Abhishek-Jalkhare/tiny-engineer/docs/3d/parametric-design.md

# Parametric design (different servo sizes)

[`3d_models/cad/TinyEngineer.f3d`](../../3d_models/cad/TinyEngineer.f3d) is the parametric Fusion source for the robot. Printed pockets, mounting tabs, shaft clearance, and M2 screw pilots are driven by Fusion **user parameters**. Change those values and the assembly rebuilds for a different micro servo or a tighter/looser screw fit.

Presets live in [`servos.json`](../../3d_models/fusion/TinyEngineerTools/servos.json). **TinyEngineer Tools** writes them into the `.f3d`, then exports print meshes under `parts/{servo_id}/3mf/` (and matching `stl/`) plus STEP CAD under `parts/{servo_id}/step/`.

```mermaid
flowchart LR
  json["servos.json presets"]
  cfg["Servo Configurator"]
  f3d["TinyEngineer.f3d user params"]
  parts["parts/servo_id meshes"]
  json --> cfg --> f3d --> parts
```

## Which servo

Servo size sets the size of the **whole robot**. Desk, chair, body, and pockets all scale with the preset. Pick the servo first, then print the matching `parts/{servo_id}/3mf/` folder.

Built-in presets in [`servos.json`](../../3d_models/fusion/TinyEngineerTools/servos.json):

| Model | `servo_id` | When to use |
| --- | --- | --- |
| **Tower Pro SG90** (recommended) | `sg90` | Easiest to buy. Bigger desk — electronics are easier to fit and assemble. |
| **Feetech FS0307** | `fs0307` | More compact. Looks better if you want a smaller robot. |
| **EMAX ES9051** | `es9051` | Compact — similar footprint to FS0307, slightly taller body. |
| **PowerHD HD-1370A** | `hd1370a` | Still supported for backward compatibility. Not the pick for a new build. |

A non-standard servo is fine: measure it, add a preset, run the configurator ([Add a new servo](#add-a-new-servo)). Print parts that match that `servo_id`.

Print matching `parts/{servo_id}/3mf/`: [`sg90`](../../3d_models/parts/sg90/3mf/), [`fs0307`](../../3d_models/parts/fs0307/3mf/), [`es9051`](../../3d_models/parts/es9051/3mf/), [`hd1370a`](../../3d_models/parts/hd1370a/3mf/).

## Servo parameters

Each preset in `servos.json` is a map of Fusion user-parameter names to expressions such as `"20 mm"`. The configurator ([`servo.py`](../../3d_models/fusion/TinyEngineerTools/servo.py)) writes those into the open design. It refuses names that are not already user parameters in the `.f3d` — do not invent keys.

Servo body dimensions used as Fusion user parameters

### Body and tabs

| Parameter | Meaning |
| --- | --- |
| `servo_body_width` | Body length between the two mounting tabs (tabs not included). |
| `servo_body_height` | Body height, from the mounting-tab plane to the opposite face. |
| `servo_body_depth` | Body thickness (front to back). |
| `servo_mount_width` | How far each mounting tab sticks out from the body. |
| `servo_mount_thickness` | Tab thickness. |

### Gearbox and shaft stack

| Parameter | Meaning |
| --- | --- |
| `servo_gearbox_height` | Gearbox step sitting on the body. |
| `servo_shaft_housing_height` | Boss around the output shaft, above the gearbox. |
| `servo_gearbox_padding` | How far the gearbox / shaft stack is inset from the body edge (the asymmetric “fat” side of typical micro servos). |

### Shaft

| Parameter | Meaning |
| --- | --- |
| `servo_shaft_position` | Distance from the body end to the shaft axis. |
| `servo_shaft_length` | How far the spline shaft sticks out. |
| `servo_shaft_radius` | Shaft radius (not diameter). |

### Mount holes

`servo_mount_hole_radius` is in `servos.json` but not drawn on the diagram.

| Parameter | Meaning |
| --- | --- |
| `servo_mount_hole_depth_offset` | Hole shift along body depth from the tab centerline. |
| `servo_mount_hole_width_offset` | Hole shift along the tab (toward or away from the body). |
| `servo_mount_hole_radius` | Screw-hole radius in the tabs. |

### Not a dimension

| Parameter | Meaning |
| --- | --- |
| `servo_id` | Short lowercase folder id (`hd1370a`, `fs0307`, `sg90`, `es9051`). The configurator writes it; the exporter uses it. |

## M2 screw holes

Assembly uses **M2 screws** that thread directly into the printed PLA/PETG (no heat-set inserts). Pilot-hole size is a Fusion **user parameter**, not a servo preset:

| Parameter | Meaning |
| --- | --- |
| `screw_thread_diameter` | Modeled diameter of M2 self-tapping pilot holes in the printed parts. |

Related (usually leave alone): `screw_head_diameter`, `screw_head_height` — countersink / head clearance for the same fasteners.

`screw_thread_diameter` is **not** in [`servos.json`](../../3d_models/fusion/TinyEngineerTools/servos.json). Change it in Fusion (**Modify → Change Parameters**), then run **Tiny Engineer Parts Exporter** again.

### Why dial it in

Print tolerances vary by printer, material, and slicer. FDM holes often print smaller than modeled, so the CAD default is slightly oversized relative to an M2 major diameter (~2.0 mm). On some printers the hole still comes out large enough that the screw **slides through** instead of cutting a thread — mounting gets loose.

### Use `ScrewSizingTest` first

1. Print [`ScrewSizingTest.3mf`](../../3d_models/README.md#print-first) from your `parts/{servo_id}/3mf/` folder (quick, small).
2. Each hole is labeled with its diameter (about **2.00–2.40 mm** in **0.05 mm** steps).
3. Drive an M2 screw into each hole. Prefer the **tightest** hole that still lets the screw cut a clean thread (firm bite, not free-spinning, not so tight you strip the plastic).
4. Set `screw_thread_diameter` to that labeled value and re-export before printing the full set.

Print [`ServoSizingTester`](../../3d_models/README.md#print-first) in the same “print first” pass for servo pocket fit.

### Recommended / tested values

| Value | When |
| --- | --- |
| **2.1 mm** | CAD default and shipped `parts/*/3mf/` exports. Tested path on a **Creality Ender 3 V3 SE**, PLA, ~0.16 mm layer height ([printing notes](../hardware-for-software-engineers/06-3d-printing-and-mechanical-build.md)). |
| Smaller (e.g. 2.05–2.15 mm) | Pilot too tight to start a thread without cracking — pick from `ScrewSizingTest`. |
| Larger (e.g. 2.25–2.35 mm) | Screws feel loose / slide through on your printer — pick from `ScrewSizingTest`. |

Always trust **your** `ScrewSizingTest` result over the table if they disagree.

## TinyEngineer Tools add-in

**TinyEngineer Tools** is a Fusion add-in for [`cad/TinyEngineer.f3d`](../../3d_models/cad/TinyEngineer.f3d). It writes servo dimensions from [`TinyEngineerTools/servos.json`](../../3d_models/fusion/TinyEngineerTools/servos.json) into Fusion user parameters, and exports selected `PRINT_LAYOUT` children as `.3mf` / binary `.stl` / `.step` (PRINT_LAYOUT with one child visible, so captured print pose stays). STL/3MF use Save as Mesh; STEP uses File → Export.

Fusion must know about the add-in folder. Folder name, `TinyEngineerTools.py`, and `TinyEngineerTools.manifest` must stay the same.

Official Autodesk steps: [How to install an add-in or script](https://www.autodesk.com/support/technical/article/caas/sfdcarticles/sfdcarticles/How-to-install-an-ADD-IN-and-Script-in-Fusion-360.html).

### Point Fusion at this repo

Fusion remembers the path. Code stays in git. Reload after edits (see below).

1. Open Fusion.
2. Open **Utilities → Add-Ins → Scripts and Add-Ins**. Shortcut: **Shift+S**.
3. Open the **Add-Ins** tab.
4. Click the green **+** next to **Script of add-in from device**.
5. Browse to `3d_models/fusion/TinyEngineerTools/` in this repo and select the folder.
6. Select **TinyEngineerTools** in the list and click **Run**.
7. Optional: enable **Run on Startup** so Fusion starts it every launch.

### Use the commands

Open [`cad/TinyEngineer.f3d`](../../3d_models/cad/TinyEngineer.f3d) and stay in the **Design** workspace. Both commands live under **Utilities → Add-ins**.

#### TinyEngineer Servo Configurator

Select a servo model and apply dimensions, including `servo_id` (short lowercase id such as `sg90`).

The command reads [`servos.json`](../../3d_models/fusion/TinyEngineerTools/servos.json), previews the values, and writes them into the design’s user parameters. Use this to preview a preset in the open design; Parts Exporter can also apply selected servos during export.

#### Tiny Engineer Parts Exporter

A command dialog asks what to export (all checkboxes **on** by default):

* **Servos** — each preset in [`servos.json`](../../3d_models/fusion/TinyEngineerTools/servos.json)
* **Parts** — each direct `PRINT_LAYOUT` child in a scrollable table, with **Select all** / **Deselect all**
* **Formats** — `3MF`, `STL`, `STEP`

Then choose an export folder.

For each selected servo the add-in applies that preset’s parameters, then exports each selected part separately. For each part it temporarily hides the others, keeps that child visible in its saved print orientation, and writes the checked formats under that servo’s folder:

* `{servo_id}/3mf/{name}.3mf` (if 3MF selected)
* `{servo_id}/stl/{name}.stl` binary STL (if STL selected)
* `{servo_id}/step/{name}.step` STEP CAD via File → Export (if STEP selected)
* `{servo_id}/README.md` with that servo’s parameters from `servos.json`

After the run, visibility and the design’s previous servo parameters are restored. A progress dialog stays up so Fusion can paint; Cancel stops after the current part.

## Add a new servo

1. Measure a real unit (prefer calipers over datasheet marketing sizes).
2. Copy an existing object in [`servos.json`](../../3d_models/fusion/TinyEngineerTools/servos.json); keep the same keys; set a unique `servo_id`.
3. Reload the add-in, run Servo Configurator, confirm Fusion parameters update.
4. Print [`ServoSizingTester`](../../3d_models/README.md#print-first) and [`ScrewSizingTest`](../../3d_models/README.md#print-first) first (servo pocket + M2 pilot), then export.

The configurator refuses unknown Fusion parameter names. Do not invent keys that are not already user parameters in the `.f3d`.
