Abhishek-Jalkhare/tiny-engineer/3d_models/laptop_screens/laptop-screens-es9051.pdf

# Tiny Engineer - laptop screen inserts: Printed background

Servo preset: EMAX ES9051 (es9051) | Print one page that suits your printer.

Background and text in colour; a black-only printer prints them as greys. Most ink.
Insert 37.2 x 28.4 mm (cut on the grey line). Visible window 36.8 x 19.9 mm, 0.2 mm from the left and 1.7 mm from the top edge.
Slide the paper insert, then a same-size piece of clear PET, into the lid pocket in front of LaptopScreen.
10 mm | 0 | 10 | 20 | 30 | 40 | 50 Square must measure 10 x 10 mm and the ruler 50 mm. If not, reprint at 100% / Actual size (scaling off).

~/tiny-engineer$ pio run
Processing esp32-c3-devkitm-1 (espressif32) -------------------------------------------Compiling .pio/build/src/anim/poses.cpp.o Compiling .pio/build/src/http/routes.cpp.o Compiling .pio/build/src/servos/park.cpp.o Linking .pio/build/firmware.elf
Checking size .pio/build/firmware.elf
RAM: | [== | ] 17.4% (57012 bytes)
Flash: [===== | ] 52.1% (1023890 bytes)
Building .pio/build/firmware.bin
========== [SUCCESS] Took 12.84 seconds ========== ~/tiny-engineer$ _

# es9051 - Build output

1 // wave hello, then get back to work 2 void greet(Robot &bot) {
3 | for (int i = 0; i < 3; i++) {
4 | bot.arm(Side::Right, 0.8f);
5 | delay(180);
6 | bot.arm(Side::Right, -0.2f);
7 | delay(180);
8 | }
9 | bot.say("Hello, world!");
10 | bot.pose("typing");
11 }
12

# es9051 - Source code

> fix the failing servo test

* Reading test/servos/test_park.cpp
* The test expects the elbow to park at 0.0, but the default is now -0.1.
* Updating the expected value...
- TEST_ASSERT_EQUAL_FLOAT(0.0f, pose); + TEST_ASSERT_EQUAL_FLOAT(-0.1f, pose); * Ran pio test -e native: 42 passed

> _

# es9051 - AI agent chat

Guru Meditation Error: Core 0 panic'ed
(Load access fault). Exception was unhandled.

Core 0 register dump:
MEPC | : 0x42008a3e RA | : 0x42008a1c
SP | : 0x3fc9b2f0 GP | : 0x3fc8e400
MTVAL | : 0x00000000 <- null pointer

Backtrace:
0x42008a3e in Coffee::refill() at mug.cpp:42 0x42004f10 in Engineer::morning() at day.cpp:7 0x42003c88 in loop() at main.cpp:118

Rebooting...

# es9051 - Crash / stack trace

**** TINY ENGINEER BASIC V2 ****
64K RAM SYSTEM 38911 BASIC BYTES FREE

READY.
10 PRINT "HELLO, HUMAN"
20 GOTO 10
RUN
HELLO, HUMAN
HELLO, HUMAN
HELLO, HUMAN
HELLO, HUMAN
BREAK IN 10
READY.
_

# es9051 - Retro computer

HOW DO YOU DO. PLEASE STATE YOUR PROBLEM. > My robot keeps waving at me.
WHY DO YOU SAY YOUR ROBOT KEEPS WAVING AT YOU?
> Maybe it wants a coffee.
YOU DON'T SEEM QUITE CERTAIN.
> I am never certain before coffee. HOW LONG HAVE YOU BEEN NEVER CERTAIN BEFORE COFFEE?
> Since I started writing firmware. TELL ME MORE ABOUT WRITING FIRMWARE. > _

# es9051 - ELIZA-style chat

| o o |
'--+--'
/| |\

### |___|

### TINY ENGINEER

booting desk robot...
[##########--------]

# es9051 - Tiny Engineer splash

## draw or glue your screen inside the dashed line (visible area)

# es9051 - Blank template

$ explain --to duck src/servos/park.cpp

__
<(o )___ | So the elbow parks at 0.0
( ._> / | because the default is...
`---'
| ...-0.1. Oh.
| Never mind. Thanks, duck.

duck: *squeak*

# es9051 - Rubber duck debugging

.--. | [ | 0.000000] Linux version 6.12-te
|o_o | | [ | 0.412718] esp32: hello from below
|:_/ | | [ OK ] Mounted /desk
// | \ \ | [ OK ] Started coffee.service
(| | | ) | [ OK ] Started tiny-engineer.service
/'\_ | _/`\ | [ OK ] Reached target Productivity
\___)=(___/

tiny-engineer login: _

Tux by Larry Ewing, made with The GIMP

# es9051 - Linux boot (Tux)

SCORE 00420 | HI 09001
#o###o# | #o###o# | #o###o# | #o###o#

/ ' ' \ | / ' ' \ | / ' ' \ | / ' ' \
| | | _/^\_
LIVES ^ ^ ^ | CREDIT 01

# es9051 - Pixel aliens

################ | > mining...

## | #### | ## | > found: 3 x coffee bean

## | #### | ## | > found: 1 x loose M2 screw

#### | | #### | A quiet green neighbour

#### #### #### | is standing behind

#### #### #### | the robot.

# es9051 - Blocky neighbour

| .-------. | | TE-9000 DESK UNIT
| .' .---. '. | | all systems nominal
/ | ( (@) ) | \
\ | '---' | / | > open the pod bay doors
'. | .'
| '-------' | | I can't do that.
| | | I can open a pull
| | | request, though.

# es9051 - TE-9000 console

~/tiny-engineer$ pio run
Processing esp32-c3-devkitm-1 (espressif32) -------------------------------------------Compiling .pio/build/src/anim/poses.cpp.o Compiling .pio/build/src/http/routes.cpp.o Compiling .pio/build/src/servos/park.cpp.o Linking .pio/build/firmware.elf
Checking size .pio/build/firmware.elf
RAM: | [== | ] 17.4% (57012 bytes)
Flash: [===== | ] 52.1% (1023890 bytes)
Building .pio/build/firmware.bin
========== [SUCCESS] Took 12.84 seconds ========== ~/tiny-engineer$ _

# es9051 - Build output

1 // wave hello, then get back to work 2 void greet(Robot &bot) {
3 | for (int i = 0; i < 3; i++) {
4 | bot.arm(Side::Right, 0.8f);
5 | delay(180);
6 | bot.arm(Side::Right, -0.2f);
7 | delay(180);
8 | }
9 | bot.say("Hello, world!");
10 | bot.pose("typing");
11 }
12

# es9051 - Source code

> fix the failing servo test

* Reading test/servos/test_park.cpp
* The test expects the elbow to park at 0.0, but the default is now -0.1.
* Updating the expected value...
- TEST_ASSERT_EQUAL_FLOAT(0.0f, pose); + TEST_ASSERT_EQUAL_FLOAT(-0.1f, pose); * Ran pio test -e native: 42 passed

> _

# es9051 - AI agent chat

Guru Meditation Error: Core 0 panic'ed
(Load access fault). Exception was unhandled.

Core 0 register dump:
MEPC | : 0x42008a3e RA | : 0x42008a1c
SP | : 0x3fc9b2f0 GP | : 0x3fc8e400
MTVAL | : 0x00000000 <- null pointer

Backtrace:
0x42008a3e in Coffee::refill() at mug.cpp:42 0x42004f10 in Engineer::morning() at day.cpp:7 0x42003c88 in loop() at main.cpp:118

Rebooting...

# es9051 - Crash / stack trace

**** TINY ENGINEER BASIC V2 ****
64K RAM SYSTEM 38911 BASIC BYTES FREE

READY.
10 PRINT "HELLO, HUMAN"
20 GOTO 10
RUN
HELLO, HUMAN
HELLO, HUMAN
HELLO, HUMAN
HELLO, HUMAN
BREAK IN 10
READY.
_

# es9051 - Retro computer

HOW DO YOU DO. PLEASE STATE YOUR PROBLEM. > My robot keeps waving at me.
WHY DO YOU SAY YOUR ROBOT KEEPS WAVING AT YOU?
> Maybe it wants a coffee.
YOU DON'T SEEM QUITE CERTAIN.
> I am never certain before coffee. HOW LONG HAVE YOU BEEN NEVER CERTAIN BEFORE COFFEE?
> Since I started writing firmware. TELL ME MORE ABOUT WRITING FIRMWARE. > _

# es9051 - ELIZA-style chat

| o o |
'--+--'
/| |\

### |___|

### TINY ENGINEER

booting desk robot...
[##########--------]

# es9051 - Tiny Engineer splash

## draw or glue your screen inside the dashed line (visible area)

# es9051 - Blank template

$ explain --to duck src/servos/park.cpp

__
<(o )___ | So the elbow parks at 0.0
( ._> / | because the default is...
`---'
| ...-0.1. Oh.
| Never mind. Thanks, duck.

duck: *squeak*

# es9051 - Rubber duck debugging

.--. | [ | 0.000000] Linux version 6.12-te
|o_o | | [ | 0.412718] esp32: hello from below
|:_/ | | [ OK ] Mounted /desk
// | \ \ | [ OK ] Started coffee.service
(| | | ) | [ OK ] Started tiny-engineer.service
/'\_ | _/`\ | [ OK ] Reached target Productivity
\___)=(___/

tiny-engineer login: _

Tux by Larry Ewing, made with The GIMP

# es9051 - Linux boot (Tux)

SCORE 00420 | HI 09001
#o###o# | #o###o# | #o###o# | #o###o#

/ ' ' \ | / ' ' \ | / ' ' \ | / ' ' \
| | | _/^\_
LIVES ^ ^ ^ | CREDIT 01

# es9051 - Pixel aliens

# Tiny Engineer - laptop screen inserts: No background, colour text

Colour printer. Only the text prints, darkened to read on pale paper; the paper shows through.
Insert 37.2 x 28.4 mm (cut on the grey line). Visible window 36.8 x 19.9 mm, 0.2 mm from the left and 1.7 mm from the top edge. Slide the paper insert, then a same-size piece of clear PET, into the lid pocket in front of LaptopScreen.
10 mm | 0 | 10 | 20 | 30 | 40 | 50 Square must measure 10 x 10 mm and the ruler 50 mm. If not, reprint at 100% / Actual size (scaling off).

~/tiny-engineer$ pio run
Processing esp32-c3-devkitm-1 (espressif32) -------------------------------------------Compiling .pio/build/src/anim/poses.cpp.o Compiling .pio/build/src/http/routes.cpp.o Compiling .pio/build/src/servos/park.cpp.o Linking .pio/build/firmware.elf
Checking size .pio/build/firmware.elf
RAM: | [== | ] 17.4% (57012 bytes)
Flash: [===== | ] 52.1% (1023890 bytes)
Building .pio/build/firmware.bin
========== [SUCCESS] Took 12.84 seconds ========== ~/tiny-engineer$ _

# es9051 - Build output

1 // wave hello, then get back to work 2 void greet(Robot &bot) {
3 | for (int i = 0; i < 3; i++) {
4 | bot.arm(Side::Right, 0.8f);
5 | delay(180);
6 | bot.arm(Side::Right, -0.2f);
7 | delay(180);
8 | }
9 | bot.say("Hello, world!");
10 | bot.pose("typing");
11 }
12

# es9051 - Source code

> fix the failing servo test

* Reading test/servos/test_park.cpp
* The test expects the elbow to park at 0.0, but the default is now -0.1.
* Updating the expected value...
- TEST_ASSERT_EQUAL_FLOAT(0.0f, pose); + TEST_ASSERT_EQUAL_FLOAT(-0.1f, pose); * Ran pio test -e native: 42 passed

> _

# es9051 - AI agent chat

Guru Meditation Error: Core 0 panic'ed
(Load access fault). Exception was unhandled.

Core 0 register dump:
MEPC | : 0x42008a3e RA | : 0x42008a1c
SP | : 0x3fc9b2f0 GP | : 0x3fc8e400
MTVAL | : 0x00000000 <- null pointer

Backtrace:
0x42008a3e in Coffee::refill() at mug.cpp:42 0x42004f10 in Engineer::morning() at day.cpp:7 0x42003c88 in loop() at main.cpp:118

Rebooting...

# es9051 - Crash / stack trace

**** TINY ENGINEER BASIC V2 ****
64K RAM SYSTEM 38911 BASIC BYTES FREE

READY.
10 PRINT "HELLO, HUMAN"
20 GOTO 10
RUN
HELLO, HUMAN
HELLO, HUMAN
HELLO, HUMAN
HELLO, HUMAN
BREAK IN 10
READY.
_

# es9051 - Retro computer

HOW DO YOU DO. PLEASE STATE YOUR PROBLEM. > My robot keeps waving at me.
WHY DO YOU SAY YOUR ROBOT KEEPS WAVING AT YOU?
> Maybe it wants a coffee.
YOU DON'T SEEM QUITE CERTAIN.
> I am never certain before coffee. HOW LONG HAVE YOU BEEN NEVER CERTAIN BEFORE COFFEE?
> Since I started writing firmware. TELL ME MORE ABOUT WRITING FIRMWARE. > _

# es9051 - ELIZA-style chat

| o o |
'--+--'
/| |\

### |___|

### TINY ENGINEER

booting desk robot...
[##########--------]

# es9051 - Tiny Engineer splash

## draw or glue your screen inside the dashed line (visible area)

# es9051 - Blank template

$ explain --to duck src/servos/park.cpp

__
<(o )___ | So the elbow parks at 0.0
( ._> / | because the default is...
`---'
| ...-0.1. Oh.
| Never mind. Thanks, duck.

duck: *squeak*

# es9051 - Rubber duck debugging

.--. | [ | 0.000000] Linux version 6.12-te
|o_o | | [ | 0.412718] esp32: hello from below
|:_/ | | [ OK ] Mounted /desk
// | \ \ | [ OK ] Started coffee.service
(| | | ) | [ OK ] Started tiny-engineer.service
/'\_ | _/`\ | [ OK ] Reached target Productivity
\___)=(___/

tiny-engineer login: _

Tux by Larry Ewing, made with The GIMP

# es9051 - Linux boot (Tux)

SCORE 00420 | HI 09001
#o###o# | #o###o# | #o###o# | #o###o#

/ ' ' \ | / ' ' \ | / ' ' \ | / ' ' \
| | | _/^\_
LIVES ^ ^ ^ | CREDIT 01

# es9051 - Pixel aliens

################ | > mining...

## | #### | ## | > found: 3 x coffee bean

## | #### | ## | > found: 1 x loose M2 screw

#### | | #### | A quiet green neighbour

#### #### #### | is standing behind

#### #### #### | the robot.

# es9051 - Blocky neighbour

| .-------. | | TE-9000 DESK UNIT
| .' .---. '. | | all systems nominal
/ | ( (@) ) | \
\ | '---' | / | > open the pod bay doors
'. | .'
| '-------' | | I can't do that.
| | | I can open a pull
| | | request, though.

# es9051 - TE-9000 console

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

# es9051 - Build output

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

# es9051 - Source code

> fix the failing servo test

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

> _

# es9051 - AI agent chat

Guru Meditation Error: Core 0 panic'ed
(Load access fault). Exception was unhandled.

Core 0 register dump:
MEPC | : 0x42008a3e RA | : 0x42008a1c
SP | : 0x3fc9b2f0 GP | : 0x3fc8e400
MTVAL | : 0x00000000 <- null pointer

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

Rebooting...

# es9051 - Crash / stack trace

**** TINY ENGINEER BASIC V2 ****
64K RAM SYSTEM 38911 BASIC BYTES FREE

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

# es9051 - Retro computer

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

# es9051 - ELIZA-style chat

| o o |
'--+--'
/| |\

### |___|

### TINY ENGINEER

booting desk robot...
[##########--------]

# es9051 - Tiny Engineer splash

## draw or glue your screen inside the dashed line (visible area)

# es9051 - Blank template

$ explain --to duck src/servos/park.cpp

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

duck: *squeak*

# es9051 - Rubber duck debugging

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

tiny-engineer login: _

Tux by Larry Ewing, made with The GIMP

# es9051 - Linux boot (Tux)

SCORE 00420 | HI 09001
#o###o# | #o###o# | #o###o# | #o###o#

/ ' ' \ | / ' ' \ | / ' ' \ | / ' ' \
| | | _/^\_
LIVES ^ ^ ^ | CREDIT 01

# es9051 - Pixel aliens

# Tiny Engineer - laptop screen inserts: No background, black text

Any printer. Only the text prints, in black and grey; the paper shows through. Least ink.
Insert 37.2 x 28.4 mm (cut on the grey line). Visible window 36.8 x 19.9 mm, 0.2 mm from the left and 1.7 mm from the top edge. Slide the paper insert, then a same-size piece of clear PET, into the lid pocket in front of LaptopScreen.
10 mm | 0 | 10 | 20 | 30 | 40 | 50 Square must measure 10 x 10 mm and the ruler 50 mm. If not, reprint at 100% / Actual size (scaling off).

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

# es9051 - Build output

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

# es9051 - Source code

> fix the failing servo test

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

> _

# es9051 - AI agent chat

Guru Meditation Error: Core 0 panic'ed
(Load access fault). Exception was unhandled.

Core 0 register dump:
MEPC | : 0x42008a3e RA | : 0x42008a1c
SP | : 0x3fc9b2f0 GP | : 0x3fc8e400
MTVAL | : 0x00000000 <- null pointer

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

Rebooting...

# es9051 - Crash / stack trace

**** TINY ENGINEER BASIC V2 ****
64K RAM SYSTEM 38911 BASIC BYTES FREE

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

# es9051 - Retro computer

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

# es9051 - ELIZA-style chat

| o o |
'--+--'
/| |\

### |___|

### TINY ENGINEER

booting desk robot...
[##########--------]

# es9051 - Tiny Engineer splash

## draw or glue your screen inside the dashed line (visible area)

# es9051 - Blank template

$ explain --to duck src/servos/park.cpp

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

duck: *squeak*

# es9051 - Rubber duck debugging

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

tiny-engineer login: _

Tux by Larry Ewing, made with The GIMP

# es9051 - Linux boot (Tux)

SCORE 00420 | HI 09001
#o###o# | #o###o# | #o###o# | #o###o#

/ ' ' \ | / ' ' \ | / ' ' \ | / ' ' \
| | | _/^\_
LIVES ^ ^ ^ | CREDIT 01

# es9051 - Pixel aliens

################ | > mining...

## | #### | ## | > found: 3 x coffee bean

## | #### | ## | > found: 1 x loose M2 screw

#### | | #### | A quiet green neighbour

#### #### #### | is standing behind

#### #### #### | the robot.

# es9051 - Blocky neighbour

| .-------. | | TE-9000 DESK UNIT
| .' .---. '. | | all systems nominal
/ | ( (@) ) | \
\ | '---' | / | > open the pod bay doors
'. | .'
| '-------' | | I can't do that.
| | | I can open a pull
| | | request, though.

# es9051 - TE-9000 console

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

# es9051 - Build output

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

# es9051 - Source code

> fix the failing servo test

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

> _

# es9051 - AI agent chat

Guru Meditation Error: Core 0 panic'ed
(Load access fault). Exception was unhandled.

Core 0 register dump:
MEPC | : 0x42008a3e RA | : 0x42008a1c
SP | : 0x3fc9b2f0 GP | : 0x3fc8e400
MTVAL | : 0x00000000 <- null pointer

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

Rebooting...

# es9051 - Crash / stack trace

**** TINY ENGINEER BASIC V2 ****
64K RAM SYSTEM 38911 BASIC BYTES FREE

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

# es9051 - Retro computer

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

# es9051 - ELIZA-style chat

| o o |
'--+--'
/| |\

### |___|

### TINY ENGINEER

booting desk robot...
[##########--------]

# es9051 - Tiny Engineer splash

## draw or glue your screen inside the dashed line (visible area)

# es9051 - Blank template

$ explain --to duck src/servos/park.cpp

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

duck: *squeak*

# es9051 - Rubber duck debugging

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

tiny-engineer login: _

Tux by Larry Ewing, made with The GIMP

# es9051 - Linux boot (Tux)

SCORE 00420 | HI 09001
#o###o# | #o###o# | #o###o# | #o###o#

/ ' ' \ | / ' ' \ | / ' ' \ | / ' ' \
| | | _/^\_
LIVES ^ ^ ^ | CREDIT 01

# es9051 - Pixel aliens
