Abhishek-Jalkhare/tiny-engineer/web/media/video_preview.jpg

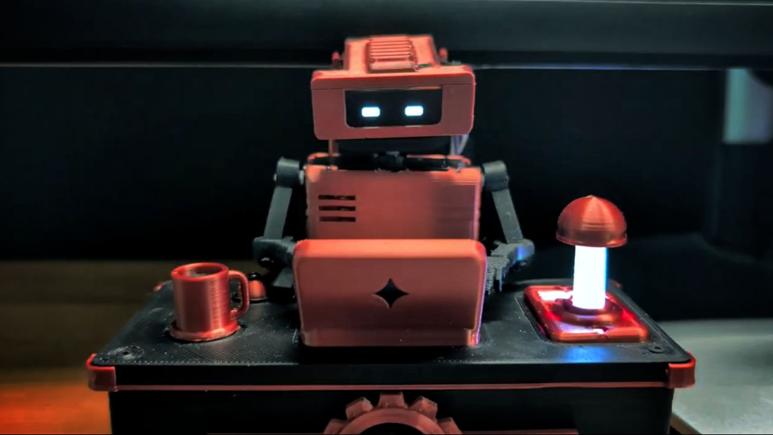
web/media/video_preview.jpg
