Abhishek-Jalkhare/tiny-engineer/3d_models/parts/fs0307/step/BottomCover.step

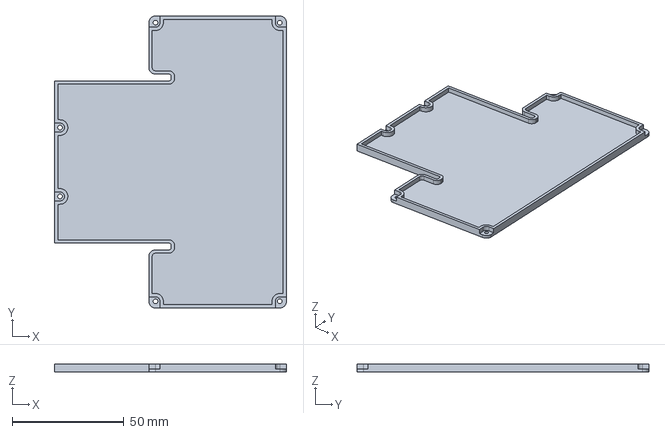
[picture p5: CAD file, 2026-10-21]
3d_models/parts/fs0307/step/BottomCover.step
103.8 x 130.6 x 3.80 mm
