Abhishek-Jalkhare/tiny-engineer/3d_models/parts/hd1370a/step/SeatRight.step

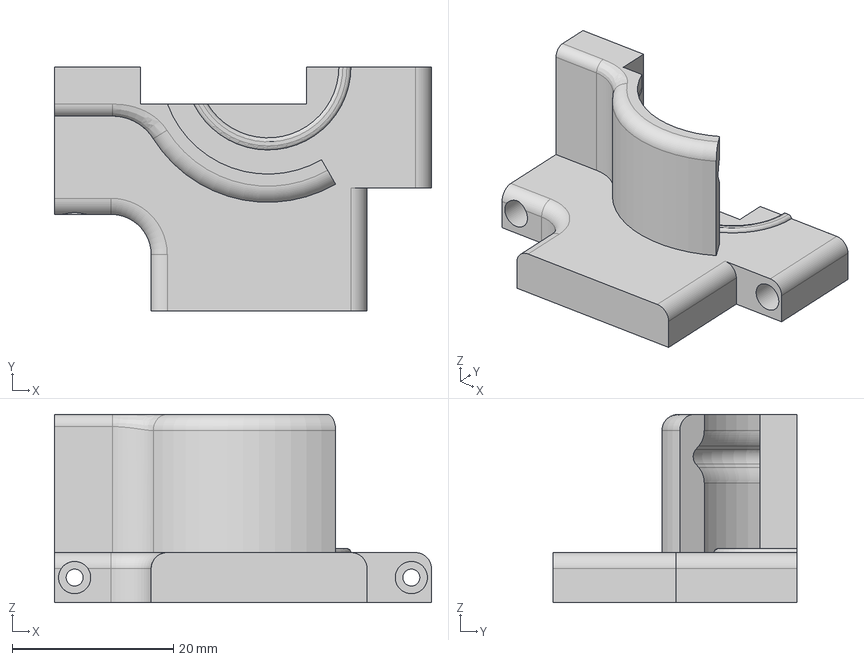
[picture p6: CAD file, 2026-10-21]
3d_models/parts/hd1370a/step/SeatRight.step
46.8 x 30.3 x 23.3 mm
