Abhishek-Jalkhare/tiny-engineer/3d_models/parts/sg90/step/Belly.step

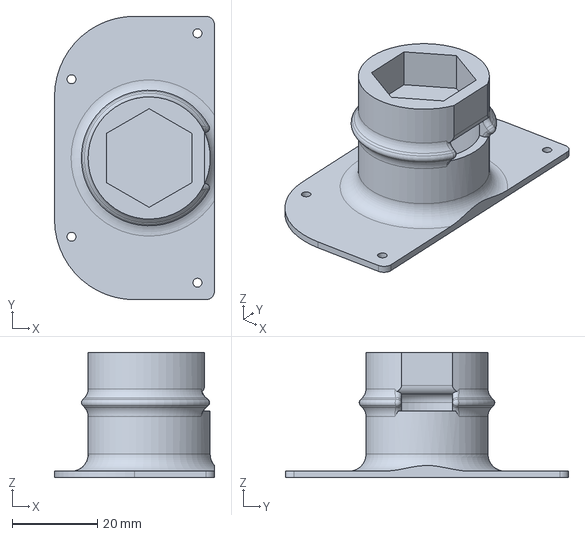
[picture p7: CAD file, 2026-10-21]
3d_models/parts/sg90/step/Belly.step
37.6 x 66.6 x 29.4 mm
