Abhishek-Jalkhare/tiny-engineer/3d_models/parts/hd1370a/step/BellyJoint.step

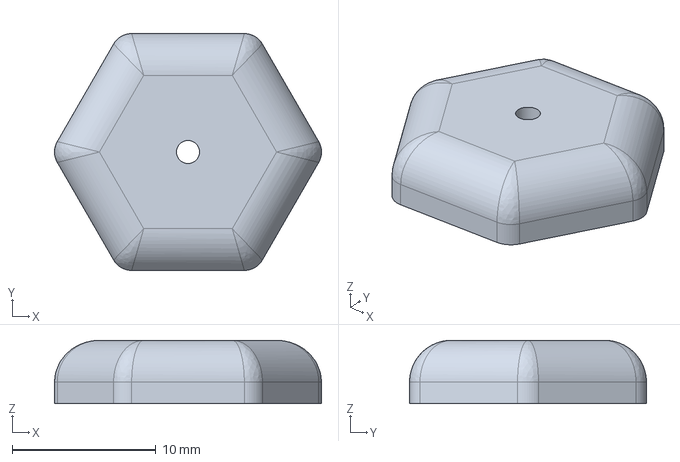
[picture p10: CAD file, 2026-10-21]
3d_models/parts/hd1370a/step/BellyJoint.step
18.6 x 16.5 x 4.40 mm
