Abhishek-Jalkhare/tiny-engineer/3d_models/parts/sg90/step/SeatRight.step

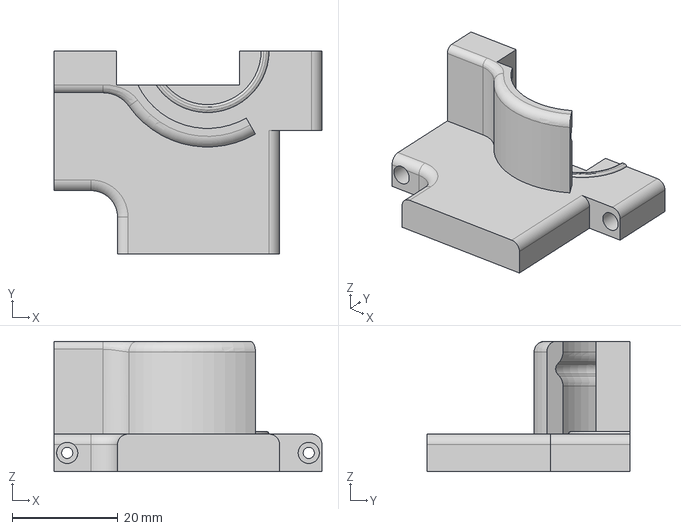
[picture p11: CAD file, 2026-10-21]
3d_models/parts/sg90/step/SeatRight.step
50.7 x 38.4 x 24.6 mm
