Abhishek-Jalkhare/tiny-engineer/3d_models/parts/fs0307/step/PartsSetA.step

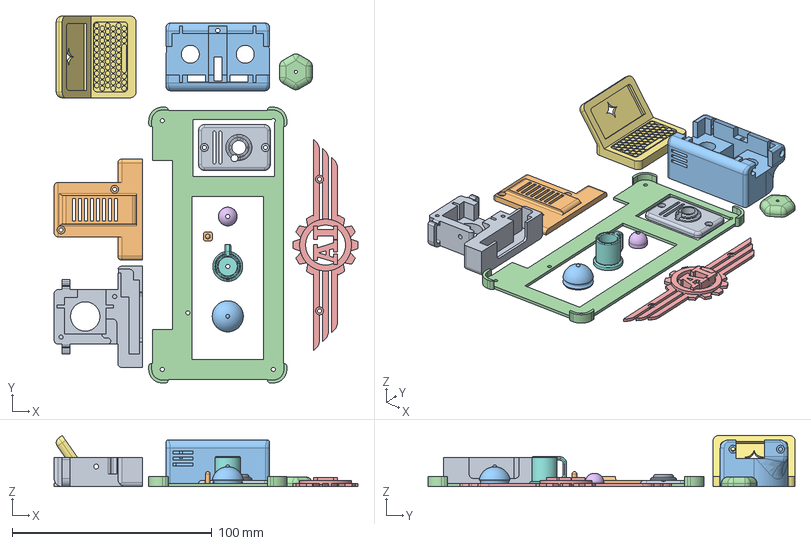
[picture p12: CAD file, 2026-10-21]
3d_models/parts/fs0307/step/PartsSetA.step
152.2 x 183.9 x 25.6 mm
