Abhishek-Jalkhare/tiny-engineer/3d_models/parts/fs0307/step/SeatLeft.step

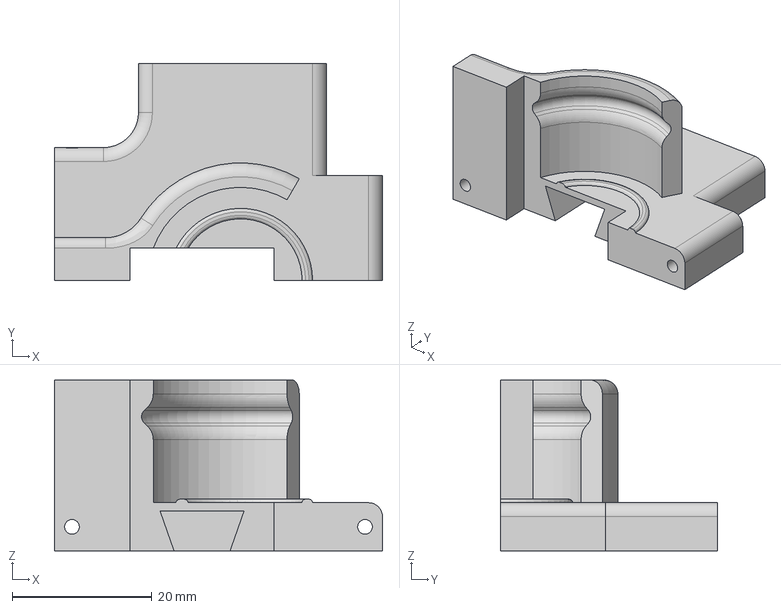
[picture p14: CAD file, 2026-10-21]
3d_models/parts/fs0307/step/SeatLeft.step
46.9 x 31.0 x 24.4 mm
