Abhishek-Jalkhare/tiny-engineer/3d_models/parts/es9051/step/PartsSetA.step

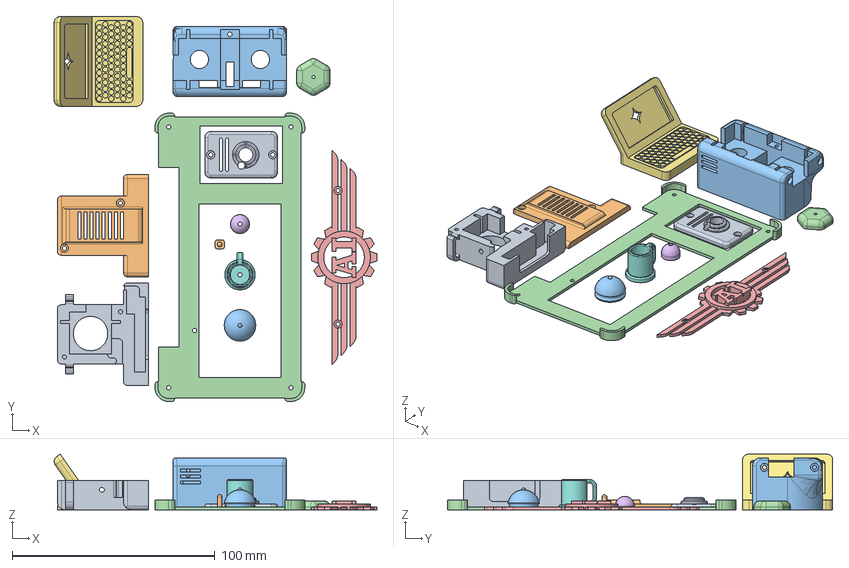
[picture p20: CAD file, 2026-10-21]
3d_models/parts/es9051/step/PartsSetA.step
159.4 x 190.1 x 27.5 mm
