Abhishek-Jalkhare/tiny-engineer/3d_models/parts/sg90/step/BellyJoint.step

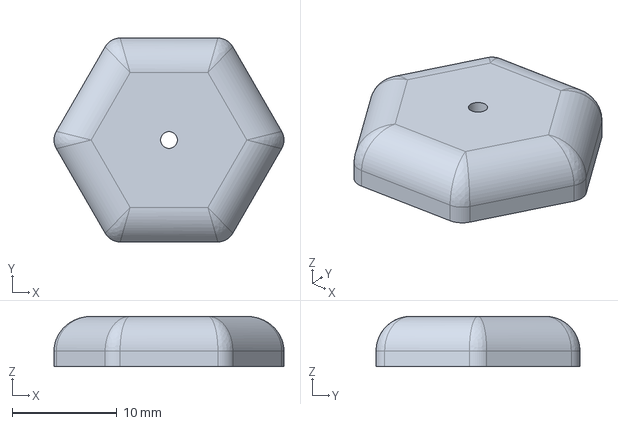
[picture p21: CAD file, 2026-10-21]
3d_models/parts/sg90/step/BellyJoint.step
22.0 x 19.5 x 4.80 mm
