Abhishek-Jalkhare/tiny-engineer/3d_models/parts/es9051/step/PartsSetB.step

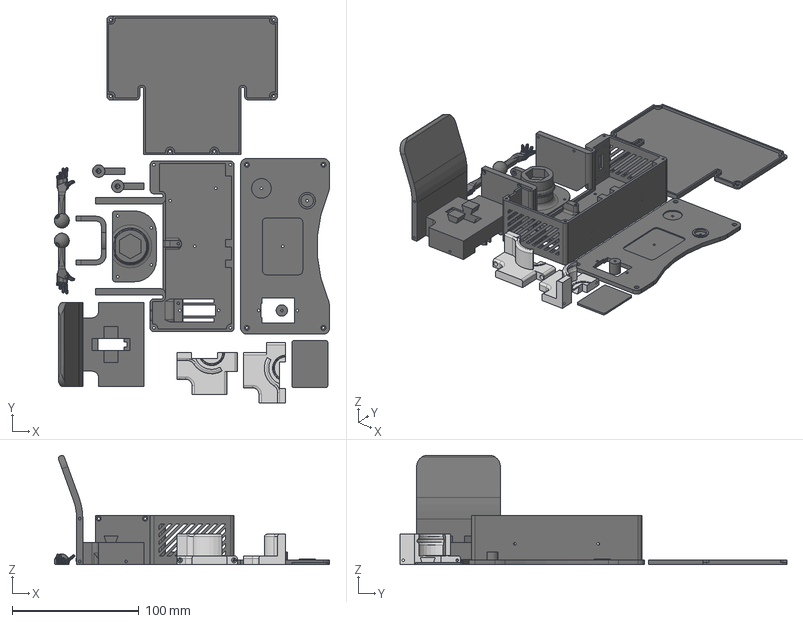
[picture p22: CAD file, 2026-10-21]
3d_models/parts/es9051/step/PartsSetB.step
217.5 x 305.6 x 86.3 mm
