Abhishek-Jalkhare/tiny-engineer/3d_models/parts/fs0307/step/BellyJoint.step

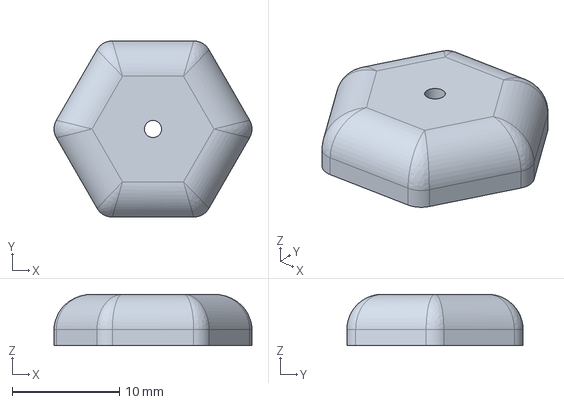
[picture p23: CAD file, 2026-10-21]
3d_models/parts/fs0307/step/BellyJoint.step
18.5 x 16.5 x 4.80 mm
