Abhishek-Jalkhare/tiny-engineer/3d_models/parts/hd1370a/step/Belly.step

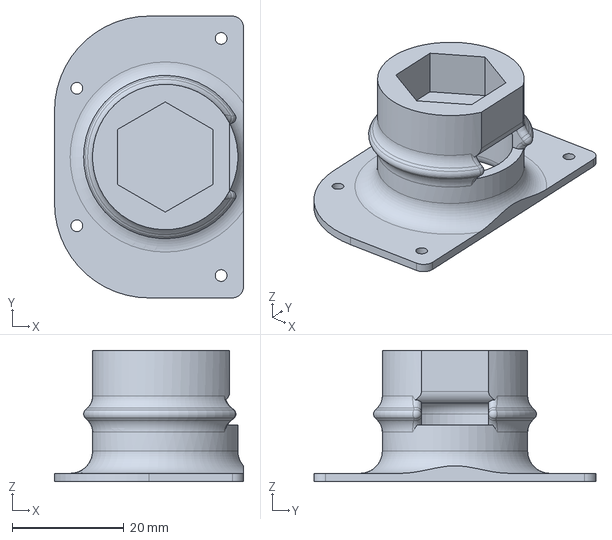
[picture p24: CAD file, 2026-10-21]
3d_models/parts/hd1370a/step/Belly.step
33.8 x 50.4 x 23.5 mm
