Abhishek-Jalkhare/tiny-engineer/3d_models/parts/sg90/step/PartsSetB.step

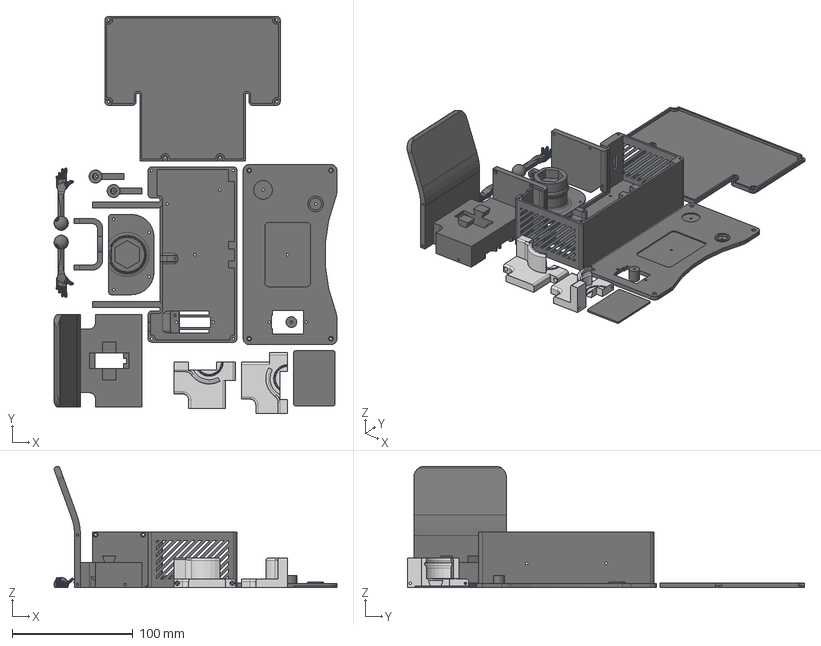
[picture p25: CAD file, 2026-10-21]
3d_models/parts/sg90/step/PartsSetB.step
234.6 x 329.3 x 100.4 mm
