Abhishek-Jalkhare/tiny-engineer/3d_models/parts/es9051/step/AiEmblem.step

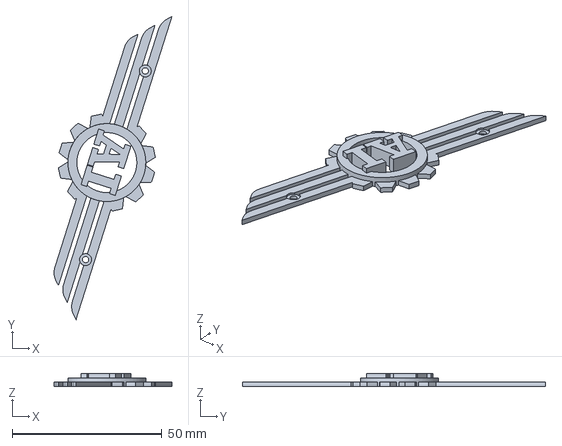
[picture p26: CAD file, 2026-10-12]
3d_models/parts/es9051/step/AiEmblem.step
39.3 x 101.1 x 4.50 mm
