Abhishek-Jalkhare/tiny-engineer/3d_models/parts/fs0307/step/Head.step

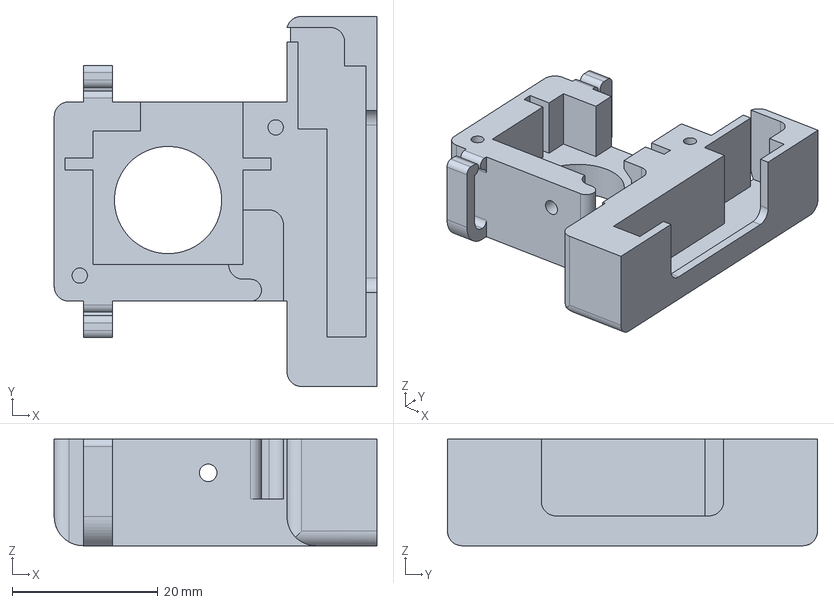
[picture p27: CAD file, 2026-10-12]
3d_models/parts/fs0307/step/Head.step
44.2 x 50.7 x 14.6 mm
