Abhishek-Jalkhare/tiny-engineer/3d_models/parts/hd1370a/step/Head.step

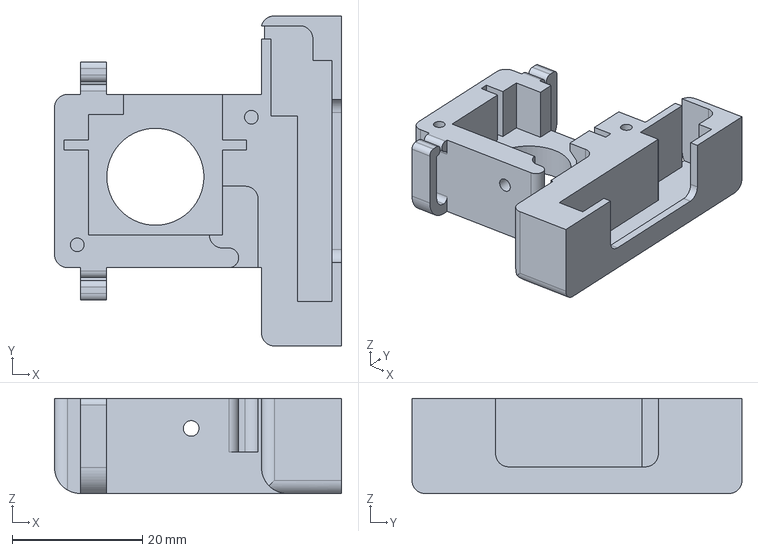
[picture p28: CAD file, 2026-10-12]
3d_models/parts/hd1370a/step/Head.step
44.1 x 50.7 x 14.6 mm
