Abhishek-Jalkhare/tiny-engineer/3d_models/parts/sg90/step/Head.step

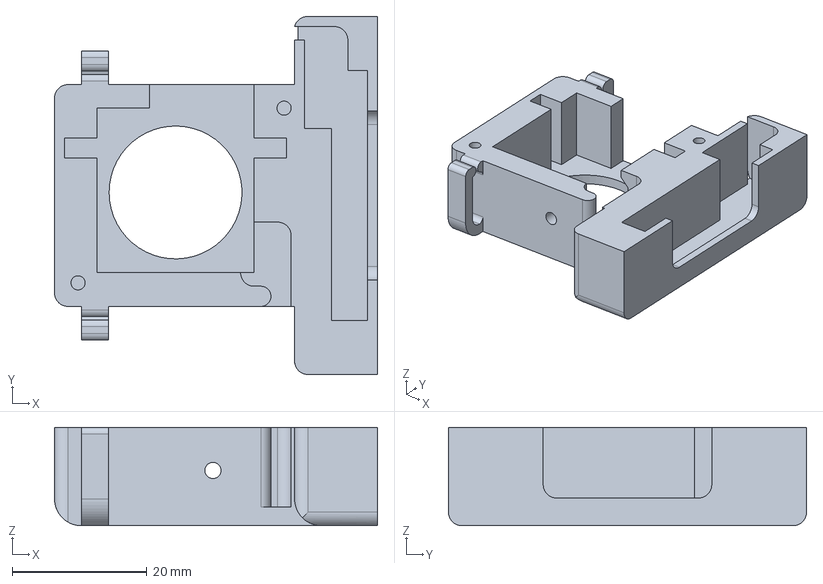
[picture p29: CAD file, 2026-10-12]
3d_models/parts/sg90/step/Head.step
47.9 x 53.1 x 14.6 mm
