Abhishek-Jalkhare/tiny-engineer/3d_models/parts/es9051/step/Bell.step

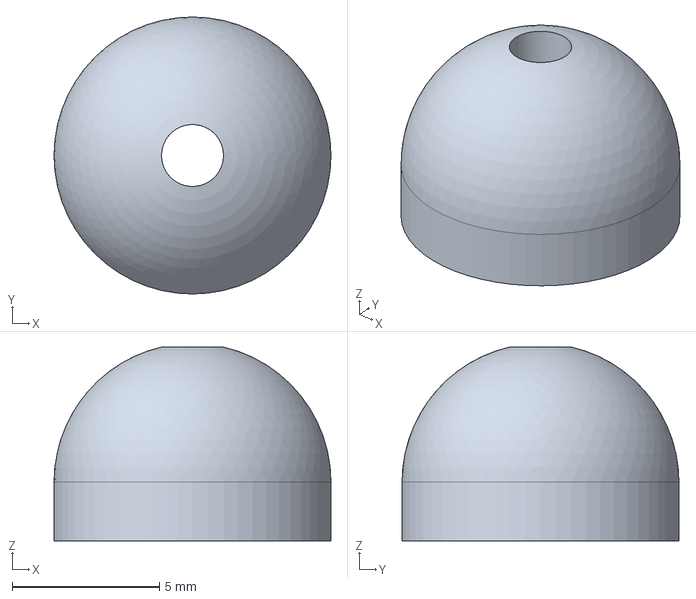
[picture p30: CAD file, 2026-10-12]
3d_models/parts/es9051/step/Bell.step
9.40 x 9.40 x 6.58 mm
