Abhishek-Jalkhare/tiny-engineer/3d_models/parts/es9051/step/Hat.step

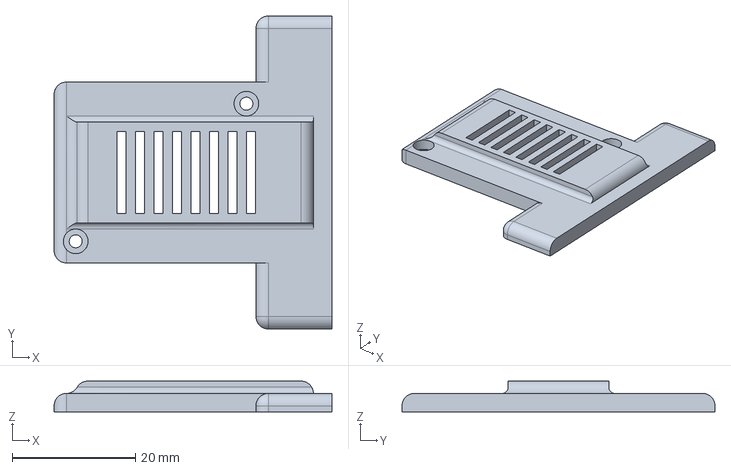
[picture p31: CAD file, 2026-10-12]
3d_models/parts/es9051/step/Hat.step
45.0 x 50.7 x 5.00 mm
