Abhishek-Jalkhare/tiny-engineer/3d_models/parts/es9051/step/LaptopCase.step

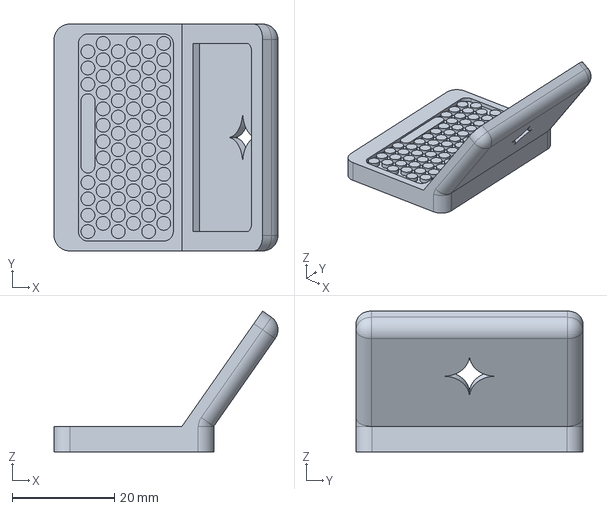
[picture p32: CAD file, 2026-10-12]
3d_models/parts/es9051/step/LaptopCase.step
43.8 x 44.4 x 27.5 mm
