Abhishek-Jalkhare/tiny-engineer/3d_models/parts/es9051/step/LampBase.step

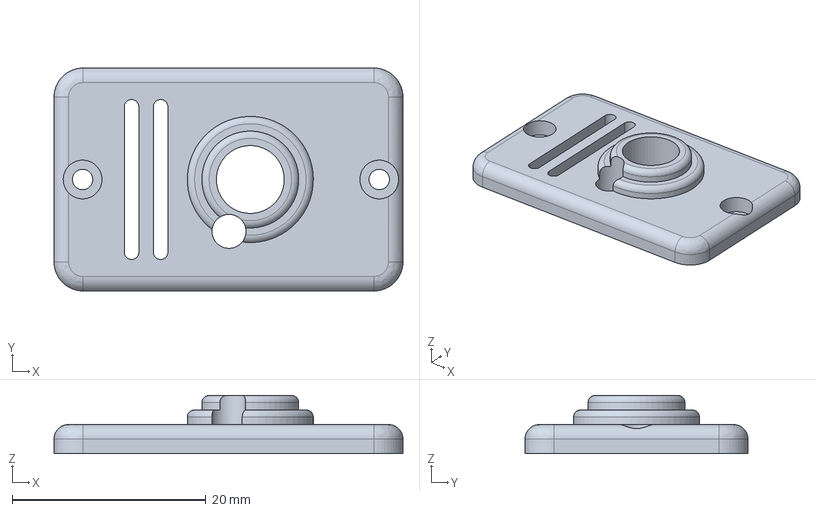
[picture p33: CAD file, 2026-10-12]
3d_models/parts/es9051/step/LampBase.step
36.0 x 23.0 x 6.00 mm
