Abhishek-Jalkhare/tiny-engineer/3d_models/parts/es9051/step/Chair.step

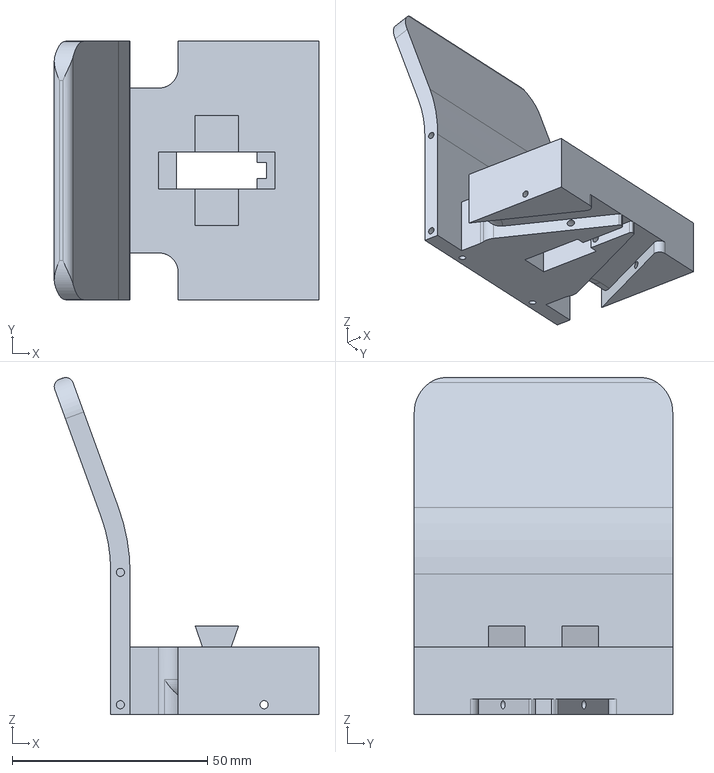
[picture p34: CAD file, 2026-10-12]
3d_models/parts/es9051/step/Chair.step
67.8 x 66.2 x 86.3 mm
