Abhishek-Jalkhare/tiny-engineer/3d_models/parts/es9051/step/Neck.step

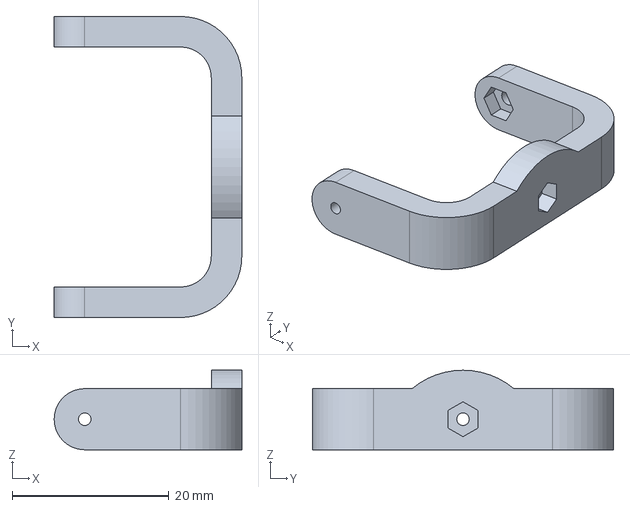
[picture p35: CAD file, 2026-10-12]
3d_models/parts/es9051/step/Neck.step
23.9 x 38.4 x 10.2 mm
