Abhishek-Jalkhare/tiny-engineer/3d_models/parts/es9051/step/LampDiffuser.step

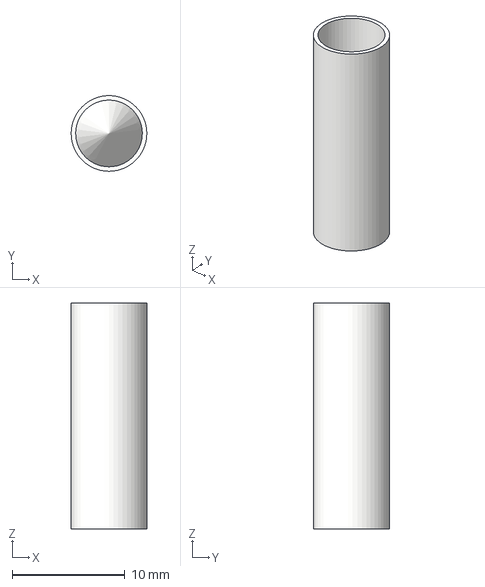
[picture p36: CAD file, 2026-10-12]
3d_models/parts/es9051/step/LampDiffuser.step
6.70 x 6.69 x 20.0 mm
