Abhishek-Jalkhare/tiny-engineer/3d_models/parts/es9051/step/DeskTop.step

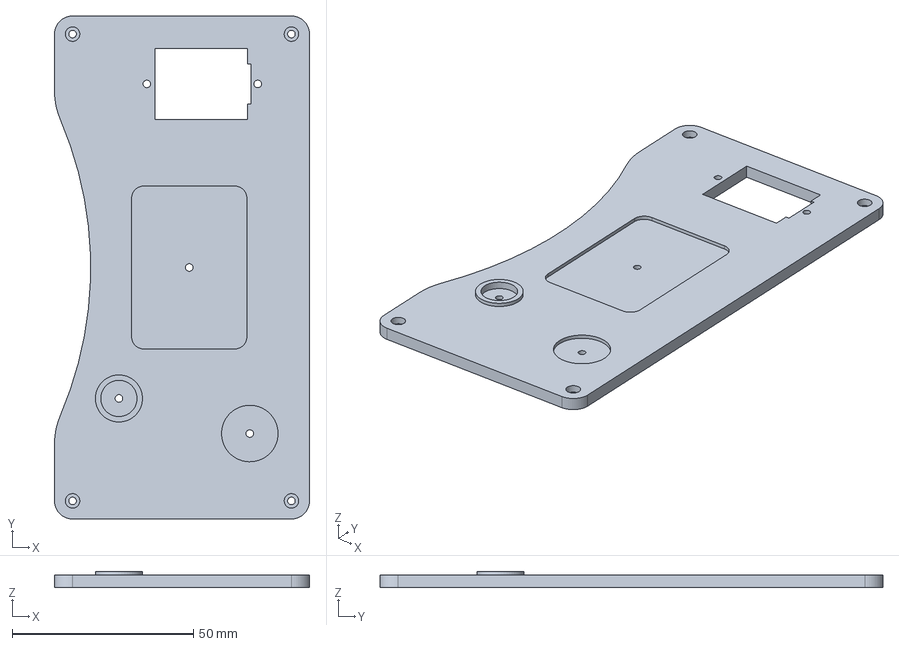
[picture p37: CAD file, 2026-10-12]
3d_models/parts/es9051/step/DeskTop.step
70.4 x 138.8 x 4.50 mm
