Abhishek-Jalkhare/tiny-engineer/3d_models/parts/es9051/step/Chest.step

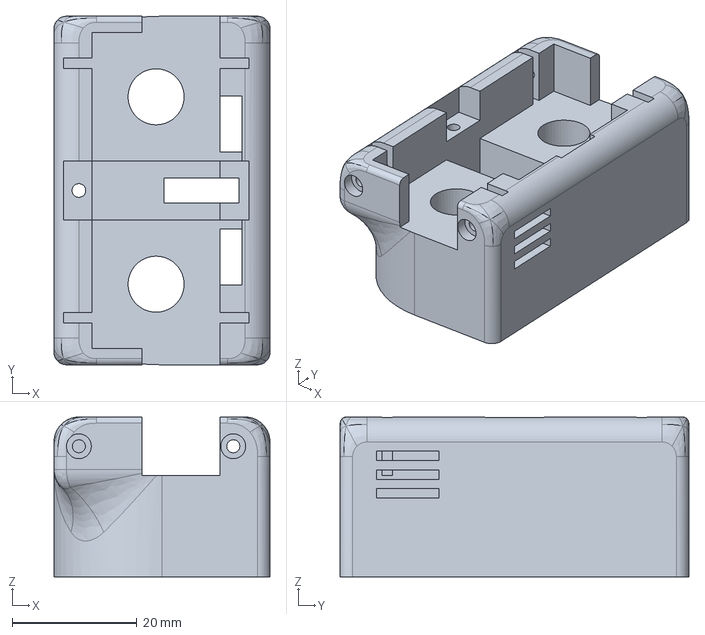
[picture p38: CAD file, 2026-10-12]
3d_models/parts/es9051/step/Chest.step
34.7 x 56.0 x 25.7 mm
