Abhishek-Jalkhare/tiny-engineer/3d_models/parts/es9051/step/ForearmRight.step

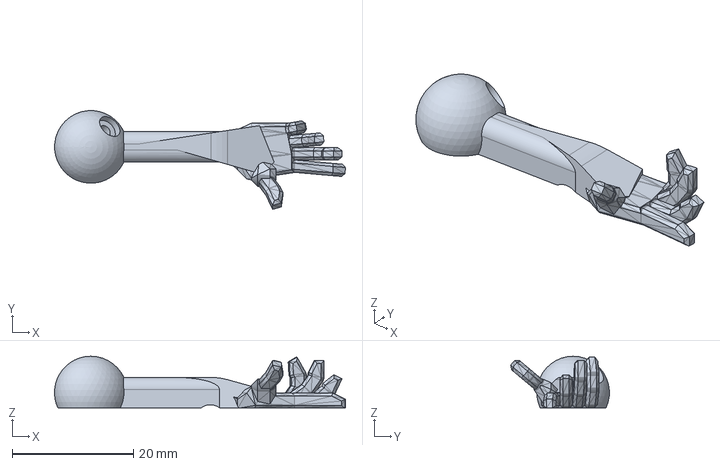
[picture p39: CAD file, 2026-10-12]
3d_models/parts/es9051/step/ForearmRight.step
48.0 x 16.3 x 8.50 mm
