Abhishek-Jalkhare/tiny-engineer/3d_models/parts/es9051/step/LampButton.step

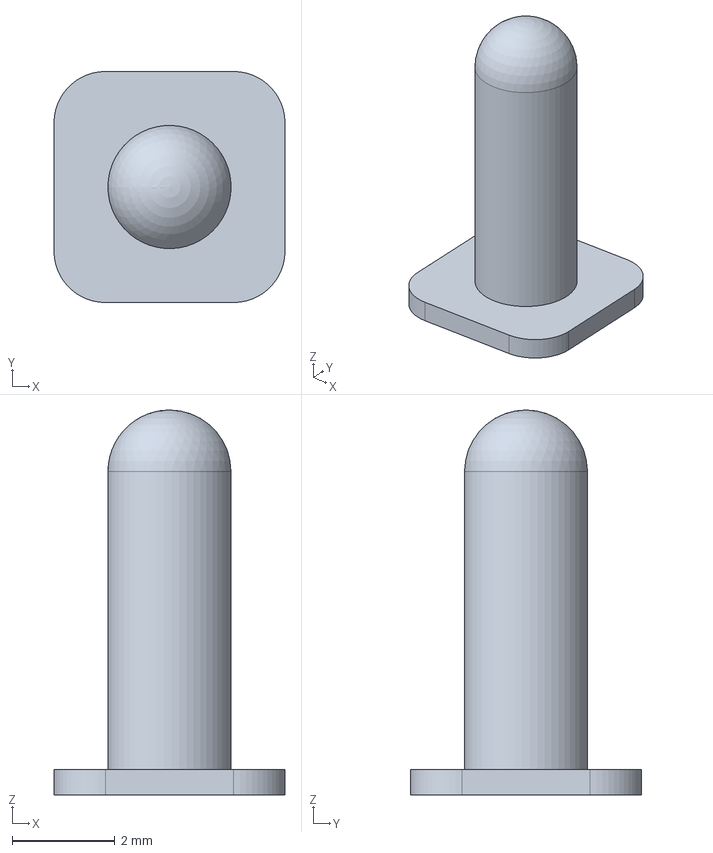
[picture p40: CAD file, 2026-10-12]
3d_models/parts/es9051/step/LampButton.step
4.50 x 4.50 x 7.50 mm
