Abhishek-Jalkhare/tiny-engineer/3d_models/parts/es9051/step/Head.step

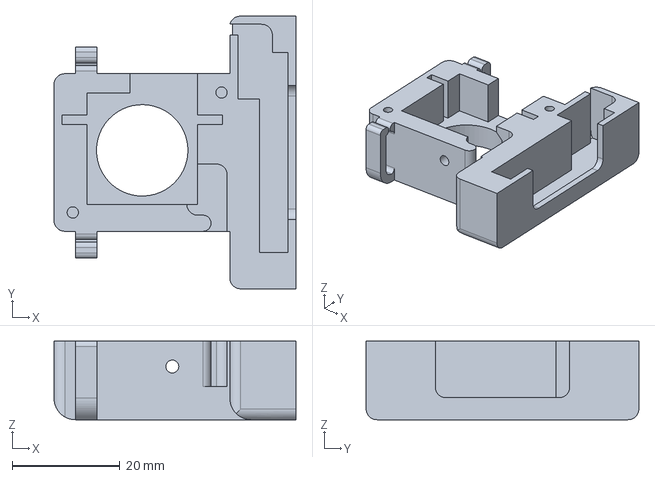
[picture p41: CAD file, 2026-10-12]
3d_models/parts/es9051/step/Head.step
45.0 x 50.7 x 14.6 mm
