Abhishek-Jalkhare/tiny-engineer/3d_models/parts/es9051/step/Mug.step

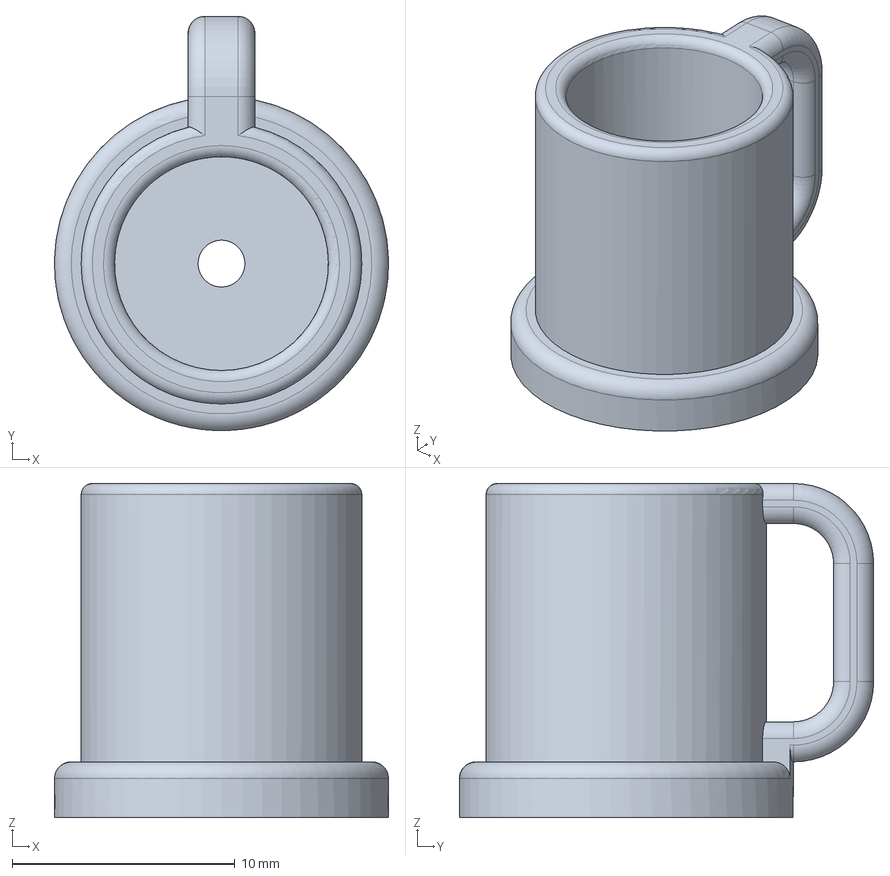
[picture p42: CAD file, 2026-10-12]
3d_models/parts/es9051/step/Mug.step
15.0 x 18.6 x 15.0 mm
