Abhishek-Jalkhare/tiny-engineer/3d_models/parts/es9051/step/UpperArm.step

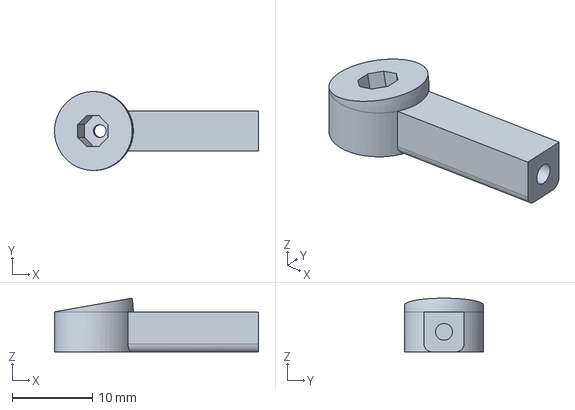
[picture p43: CAD file, 2026-10-12]
3d_models/parts/es9051/step/UpperArm.step
25.5 x 9.86 x 6.71 mm
