Abhishek-Jalkhare/tiny-engineer/3d_models/parts/es9051/step/DeskPad.step

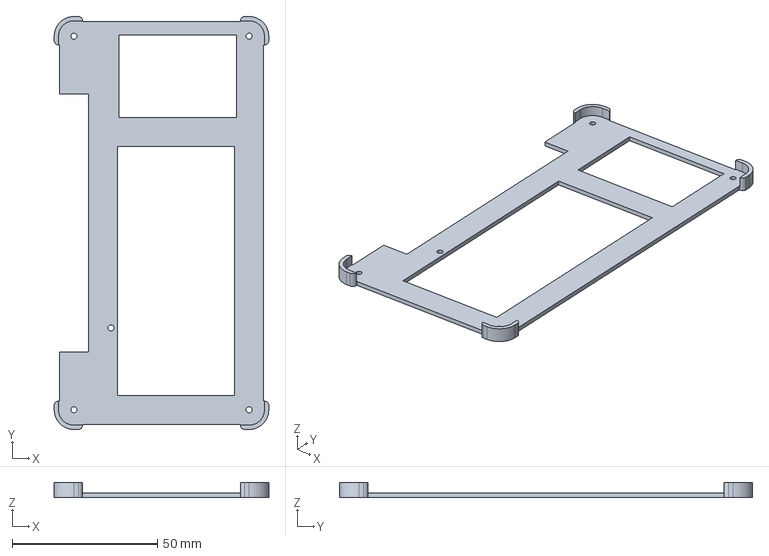
[picture p44: CAD file, 2026-10-12]
3d_models/parts/es9051/step/DeskPad.step
74.0 x 142.4 x 5.00 mm
