Abhishek-Jalkhare/tiny-engineer/3d_models/parts/es9051/step/LampCap.step

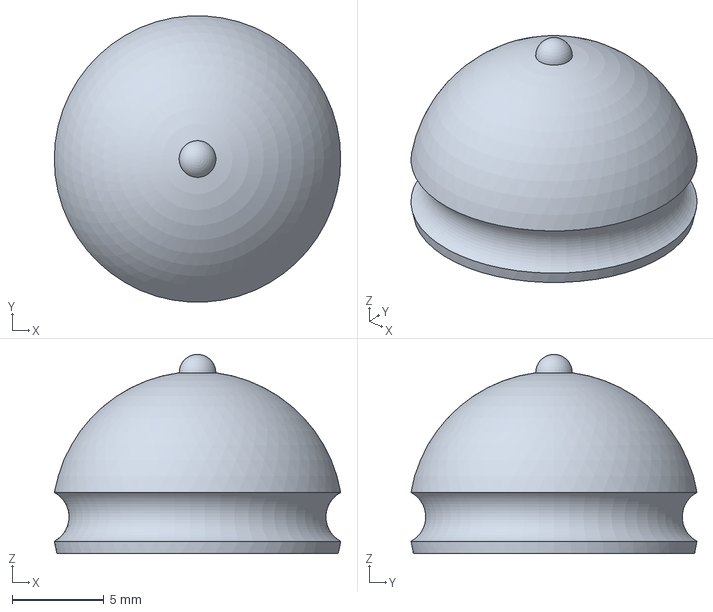
[picture p45: CAD file, 2026-10-12]
3d_models/parts/es9051/step/LampCap.step
15.6 x 15.6 x 10.9 mm
