Abhishek-Jalkhare/tiny-engineer/3d_models/parts/es9051/step/Coffee.step

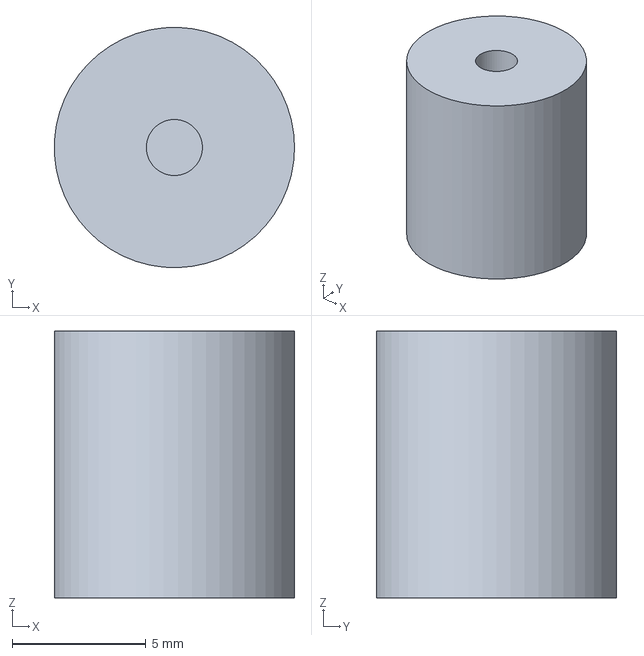
[picture p46: CAD file, 2026-10-12]
3d_models/parts/es9051/step/Coffee.step
8.99 x 9.00 x 10.0 mm
