Abhishek-Jalkhare/tiny-engineer/3d_models/parts/es9051/step/LaptopScreen.step

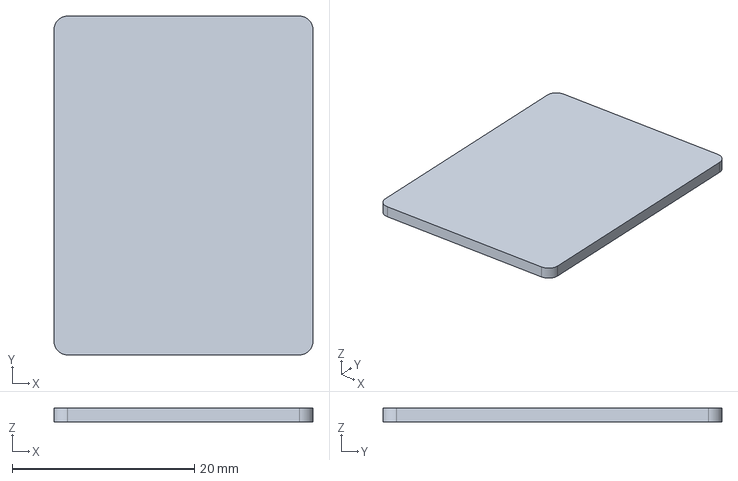
[picture p47: CAD file, 2026-10-12]
3d_models/parts/es9051/step/LaptopScreen.step
28.4 x 37.2 x 1.50 mm
