Abhishek-Jalkhare/tiny-engineer/3d_models/parts/es9051/step/ServoSizingTester.step

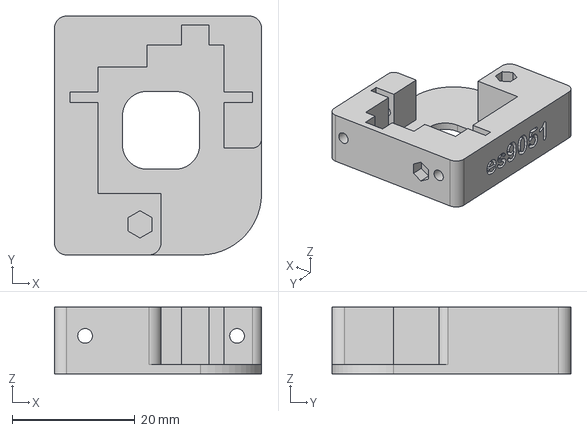
[picture p48: CAD file, 2026-10-12]
3d_models/parts/es9051/step/ServoSizingTester.step
33.8 x 39.0 x 10.9 mm
