Abhishek-Jalkhare/tiny-engineer/3d_models/parts/es9051/step/Desk.step

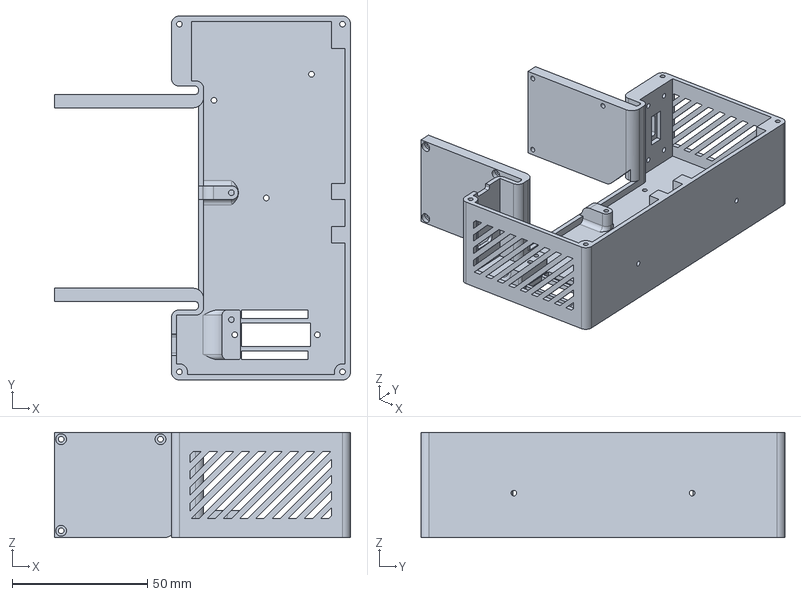
[picture p49: CAD file, 2026-10-12]
3d_models/parts/es9051/step/Desk.step
109.7 x 134.8 x 38.9 mm
