Abhishek-Jalkhare/tiny-engineer/(list of files, cad)

Other CAD files:
3d_models/parts/es9051/step/SeatRight.step
3d_models/parts/hd1370a/step/SeatLeft.step
3d_models/parts/es9051/step/BellyJoint.step
3d_models/parts/sg90/step/SeatLeft.step
3d_models/parts/fs0307/step/SeatRight.step
3d_models/parts/hd1370a/step/BottomCover.step
3d_models/parts/es9051/step/ForearmLeft.step
3d_models/cad/TinyEngineer.f3d
3d_models/parts/es9051/3mf/AiEmblem.3mf
3d_models/parts/es9051/3mf/Bell.3mf
3d_models/parts/es9051/3mf/Belly.3mf
3d_models/parts/es9051/3mf/BellyJoint.3mf
3d_models/parts/es9051/3mf/BottomCover.3mf
3d_models/parts/es9051/3mf/Chair.3mf
3d_models/parts/es9051/3mf/Chest.3mf
3d_models/parts/es9051/3mf/Coffee.3mf
3d_models/parts/es9051/3mf/Desk.3mf
3d_models/parts/es9051/3mf/DeskPad.3mf
3d_models/parts/es9051/3mf/DeskTop.3mf
3d_models/parts/es9051/3mf/ForearmLeft.3mf
3d_models/parts/es9051/3mf/ForearmRight.3mf
3d_models/parts/es9051/3mf/Hat.3mf
3d_models/parts/es9051/3mf/Head.3mf
3d_models/parts/es9051/3mf/LampBase.3mf
3d_models/parts/es9051/3mf/LampButton.3mf
3d_models/parts/es9051/3mf/LampCap.3mf
3d_models/parts/es9051/3mf/LampDiffuser.3mf
3d_models/parts/es9051/3mf/LaptopCase.3mf
3d_models/parts/es9051/3mf/LaptopScreen.3mf
3d_models/parts/es9051/3mf/Mug.3mf
3d_models/parts/es9051/3mf/Neck.3mf
3d_models/parts/es9051/3mf/PartsSetA.3mf
3d_models/parts/es9051/3mf/PartsSetB.3mf
3d_models/parts/es9051/3mf/ScrewSizingTest.3mf
3d_models/parts/es9051/3mf/SeatLeft.3mf
3d_models/parts/es9051/3mf/SeatRight.3mf
3d_models/parts/es9051/3mf/ServoSizingTester.3mf
3d_models/parts/es9051/3mf/UpperArm.3mf
3d_models/parts/es9051/step/ScrewSizingTest.step
3d_models/parts/es9051/stl/AiEmblem.stl
3d_models/parts/es9051/stl/Bell.stl
3d_models/parts/es9051/stl/Belly.stl
3d_models/parts/es9051/stl/BellyJoint.stl
3d_models/parts/es9051/stl/BottomCover.stl
3d_models/parts/es9051/stl/Chair.stl
3d_models/parts/es9051/stl/Chest.stl
3d_models/parts/es9051/stl/Coffee.stl
3d_models/parts/es9051/stl/Desk.stl
3d_models/parts/es9051/stl/DeskPad.stl
3d_models/parts/es9051/stl/DeskTop.stl
3d_models/parts/es9051/stl/ForearmLeft.stl
3d_models/parts/es9051/stl/ForearmRight.stl
3d_models/parts/es9051/stl/Hat.stl
3d_models/parts/es9051/stl/Head.stl
3d_models/parts/es9051/stl/LampBase.stl
3d_models/parts/es9051/stl/LampButton.stl
3d_models/parts/es9051/stl/LampCap.stl
3d_models/parts/es9051/stl/LampDiffuser.stl
3d_models/parts/es9051/stl/LaptopCase.stl
3d_models/parts/es9051/stl/LaptopScreen.stl
3d_models/parts/es9051/stl/Mug.stl
3d_models/parts/es9051/stl/Neck.stl
3d_models/parts/es9051/stl/PartsSetA.stl
3d_models/parts/es9051/stl/PartsSetB.stl
3d_models/parts/es9051/stl/ScrewSizingTest.stl
3d_models/parts/es9051/stl/SeatLeft.stl
3d_models/parts/es9051/stl/SeatRight.stl
3d_models/parts/es9051/stl/ServoSizingTester.stl
3d_models/parts/es9051/stl/UpperArm.stl
3d_models/parts/fs0307/3mf/Belly.3mf
3d_models/parts/fs0307/3mf/BellyJoint.3mf
3d_models/parts/fs0307/3mf/BottomCover.3mf
3d_models/parts/fs0307/3mf/Head.3mf
3d_models/parts/fs0307/3mf/PartsSetA.3mf
3d_models/parts/fs0307/3mf/PartsSetB.3mf
3d_models/parts/fs0307/3mf/SeatLeft.3mf
3d_models/parts/fs0307/3mf/SeatRight.3mf
3d_models/parts/fs0307/stl/Belly.stl
3d_models/parts/fs0307/stl/BellyJoint.stl
3d_models/parts/fs0307/stl/BottomCover.stl
3d_models/parts/fs0307/stl/Head.stl
3d_models/parts/fs0307/stl/PartsSetA.stl
3d_models/parts/fs0307/stl/PartsSetB.stl
3d_models/parts/fs0307/stl/SeatLeft.stl
3d_models/parts/fs0307/stl/SeatRight.stl
3d_models/parts/hd1370a/3mf/Belly.3mf
3d_models/parts/hd1370a/3mf/BellyJoint.3mf
3d_models/parts/hd1370a/3mf/BottomCover.3mf
3d_models/parts/hd1370a/3mf/Head.3mf
3d_models/parts/hd1370a/3mf/PartsSetA.3mf
3d_models/parts/hd1370a/3mf/PartsSetB.3mf
3d_models/parts/hd1370a/3mf/SeatLeft.3mf
3d_models/parts/hd1370a/3mf/SeatRight.3mf
3d_models/parts/hd1370a/stl/Belly.stl
3d_models/parts/hd1370a/stl/BellyJoint.stl
3d_models/parts/hd1370a/stl/BottomCover.stl
3d_models/parts/hd1370a/stl/Head.stl
3d_models/parts/hd1370a/stl/PartsSetA.stl
3d_models/parts/hd1370a/stl/PartsSetB.stl
3d_models/parts/hd1370a/stl/SeatLeft.stl
3d_models/parts/hd1370a/stl/SeatRight.stl
3d_models/parts/sg90/3mf/Belly.3mf
3d_models/parts/sg90/3mf/BellyJoint.3mf
3d_models/parts/sg90/3mf/BottomCover.3mf
3d_models/parts/sg90/3mf/Head.3mf
3d_models/parts/sg90/3mf/PartsSetA.3mf
3d_models/parts/sg90/3mf/PartsSetB.3mf
3d_models/parts/sg90/3mf/SeatLeft.3mf
3d_models/parts/sg90/3mf/SeatRight.3mf
3d_models/parts/sg90/stl/Belly.stl
3d_models/parts/sg90/stl/BellyJoint.stl
3d_models/parts/sg90/stl/BottomCover.stl
3d_models/parts/sg90/stl/Head.stl
3d_models/parts/sg90/stl/PartsSetA.stl
3d_models/parts/sg90/stl/PartsSetB.stl
3d_models/parts/sg90/stl/SeatLeft.stl
3d_models/parts/sg90/stl/SeatRight.stl
