Abhishek-Jalkhare/tiny-engineer/docs/hardware-for-software-engineers/06-3d-printing-and-mechanical-build.md

# 3D printing and mechanical build

Software lives in repos; hardware lives in **enclosures**. 3D printing is how you turn CAD into a physical body — layer by layer, with tolerances that bite if you ignore them. If you've never printed, this chapter is the missing semester: materials, fit, CAD source, and not destroying a servo by forcing it into a tight pocket. **Tiny Engineer** is the case study; the skills transfer to any printed mount or case.

---

## FDM printing in 60 seconds

**FDM** (Fused Deposition Modeling) — the common hobby printer type — melts plastic filament layer by layer.

Knobs that matter:

| Parameter | Typical starting point | What it affects |
| --- | --- | --- |
| **Layer height** | **0.16 mm** (used for the tested prints) | Surface quality vs speed |
| **Infill** | 20–30% structural | Strength vs print time |
| **Orientation** | As in the `.3mf` | Overhangs; supports (see below) |
| **Material** | **PLA** is enough; PETG also works | Ease vs toughness |

### Supports

Plastic cannot print in mid-air. An **overhang** (a surface that sticks out with nothing under it) needs **supports** — extra throwaway plastic the slicer builds like scaffolding, then you snap or dissolve off.

Supports leave scars, use filament, and make small holes and servo pockets messy.

**This project's parts are designed and oriented so they print with no supports.** Keep the `.3mf` orientation. Rotate a part "to look nicer on the bed" and you may suddenly need supports and get ugly undersides.

### What printer

All parts were printed and test-fitted on a **Creality Ender 3 V3 SE**. You should be able to print them on **any FDM printer** that can run PLA (or PETG) at typical hobby settings — the files are not locked to that machine.

No printer? You can [order the aggregated part sets from a third-party service](../3d/order-parts.md) instead of printing at home, then continue with assembly.

---

## Materials: PLA vs PETG

**PLA is sufficient** for the whole robot — desk use, indoor, this design. **PETG also works** if that's what you have (tougher, a bit stringier to print). Pick one spool if you care about color match.

| Material | Use here |
| --- | --- |
| **PLA** | Default. Fine for servo pockets, chair, desk, props |
| **PETG** | Also fine. Slightly stronger; not required |

Antenna zone: keep plastic thin/light near the ESP32 ceramic antenna. No metal paint, no foil wrap "for aesthetics."

### Special: LampDiffuser

The lamp diffuser is **one-line thin** on purpose (light transmission). Some slicers drop the walls or report empty layers unless thin-wall / Arachne settings are on. White or translucent filament. Full per-slicer notes: [LampDiffuser (thin walls)](../../3d_models/README.md#lampdiffuser-thin-walls).

---

## Tolerance and "it doesn't fit"

The models are **prepared with clearance** so printed parts and hardware (servos, screws) are meant to **fit together** without sanding as the happy path. 3D printing is still approximate — holes shrink, first layers bulge ("elephant's foot"), printers vary.

**If a servo doesn't slide in:**
- Don't force it — gears aren't meant to take press-fit stress
- Ream with a drill bit by hand, or
- Sand lightly, or
- Open the pocket in CAD and re-export

> **If you've written backend code…** Printed holes are like JSON numbers — `2.0` isn't exactly 2.0 after float serialization. These files already budget slack; a badly calibrated printer can still eat it.

**Screws:** assembly uses **M2** screws that thread directly into the printed plastic — no glue, no heat-set inserts. Shopping list (M2×4 / ×8 / ×16 + nuts; same lengths for every servo preset) lives in the [3D models README](../../3d_models/README.md#screws). Join order: [assembly guide](../3d/assembly.md). Test fit as you go.

**If M2 screws feel loose (slide instead of cutting a thread):** print tolerances ate the pilot. Print [`ScrewSizingTest.3mf`](../../3d_models/README.md#print-first) first (alongside [`ServoSizingTester`](../../3d_models/README.md#print-first)), pick the labeled hole that bites firmly, set Fusion `screw_thread_diameter` to that diameter, and re-export. CAD default / shipped parts use **2.1 mm**. Full write-up: [M2 screw holes](../3d/parametric-design.md#m2-screw-holes).

---

## Editing the CAD — Fusion 360

### Source vs export

| File | What it is |
| --- | --- |
| [`cad/TinyEngineer.f3d`](../../3d_models/cad/TinyEngineer.f3d) | **Parametric source** — full assembly in Autodesk Fusion |
| [`3d_models/parts/{servo_id}/3mf/*.3mf`](../../3d_models/parts/) | **Exported meshes** — what the printer eats |

> **If you've written backend code…** `.f3d` is the repo. `.3mf` is the release binary. Don't edit `.3mf` as source — edit Fusion, re-export.

### When to open Fusion

- Servo pocket too tight/loose after first print
- Different micro servo dimensions (use a [`servos.json`](../../3d_models/fusion/TinyEngineerTools/servos.json) preset, or add one)
- Cable routing channel for your wiring harness
- Antenna keep-out adjustment
- Desk/chair scale for your desk

Parts use **M2** screws (`screw_thread_diameter` pilot). Servo pockets follow the selected Fusion preset, not one fixed body size. Swapping servos means picking a preset (or adding one) and reprinting — not just firmware. Servo user parameters, screw pilots, the Fusion add-in (configurator + exporter), and how to add a preset: [parametric design](../3d/parametric-design.md).

### Export workflow

1. Open `TinyEngineer.f3d` in Fusion (free personal license exists)
2. Apply a servo preset; set `screw_thread_diameter` from your [`ScrewSizingTest`](../../3d_models/README.md#print-first) if needed
3. Export with **Tiny Engineer Parts Exporter** into `parts/{servo_id}/3mf/` (see [parametric design](../3d/parametric-design.md))
4. Print testers first, then the rest, and test fit

Manual single-body export is fine for a one-off tweak; keep the file under that servo’s `3mf/` folder, not a flat `3d_models/parts/` dump.

Alternatives (FreeCAD, Onshape) can work but project source is Fusion.

---

## Mechanical assembly principles

Step-by-step SOP: [assembly.md](../3d/assembly.md). Use that guide for the build sequence; principles below cover key failure modes.

### Servo installation

- **Orientation matters** — spline exit direction must match linkage. Check before screwing pocket closed
- **Screw horn with servo at center** — boot firmware or `/test/servo` to 90° first
- **Don't over-tighten horn screw** — strips plastic hub

### Range of motion before closing shell

Command each joint through safe range ([robot-movement.md](../robot-movement.md)). Listen for buzzing (stall). Adjust horns or setup-AP min/max (NVS) before trapping servos in plastic.

### USB and service access

Leave the main control board USB-C reachable for reflash. You'll flash again. Trust me. The advanced path uses a 5993 in that same role — [wiring.md](../hardware/wiring.md).

### Antenna clearance

ESP32-C3-Zero ceramic antenna needs air. Don't bury it against metal or a thick plastic wall. Wi-Fi is the control plane for your agent.

### No glue policy

Screws only — disassembly for fixes. Like modular monolith vs ball of mud.

### Desk scene

Chair, desk, laptop, bell, lamp, mug — cosmetic storytelling. Print order doesn't matter much; prioritize robot body + servos for bring-up.

Part list: [3d_models/README.md](../../3d_models/README.md).

---

## Print while you wait — parallel path

Electronics can ship slow. Start printing **structural parts** (chest, head, chair) while reading [Ch. 04](04-buses-and-protocols.md). Connect and smoke at checklist [§3–4](../getting-started.md#3-connect) — still on the desk — then one assembly run. Parallelism beats serial idle time.

---

**Next:** [Power budgets and safety](07-power-budgets-and-safety.md)

**Reference:** [assembly.md](../3d/assembly.md) · [3d_models/README.md](../../3d_models/README.md) · [cad/TinyEngineer.f3d](../../3d_models/cad/TinyEngineer.f3d) · [parametric design](../3d/parametric-design.md) · [robot-movement.md](../robot-movement.md)
