Abhishek-Jalkhare/tiny-engineer/src/robot_tick.cpp

#include "robot_tick.h"

#include <Arduino.h>

#include "animation.h"
#include "display/oled.h"
#include "hardware/rgb.h"
#include "hardware/servo_wrapper.h"
#include "network/wifi_connect.h"
#include "sleep.h"

void tickRobot() {
  const uint32_t now = millis();
  pollWifi();
  updateProvisioningOled(now);
  updateAnimation();
  // Read again: an animation applied this tick stamps its idle time after `now`.
  updateSleep(millis());
  updateRgb(now);
  pollServoPoseSave();
}
