Abhishek-Jalkhare/tiny-engineer/(commit log)

2026-10-11 refactor(http): build the web UI with Vite and embed it gzipped in the firmware (#68)
    * feat(http): embed the gzipped web UI in the firmware
    Vite builds ui/ into one self-contained page (vite-plugin-singlefile),
    and scripts/embed_ui.py gzips it into a generated header that the
    firmware serves with Content-Encoding: gzip. The UI always matches the
    firmware it ships in, so LittleFS only holds audio again: the /ui/*
    routes, the version stamp and check, and the filesystem-first OTA order
    are gone. The pre-script skips Node when ui/ is unchanged.
    Claude-Session: https://claude.ai/code/session_01VUaQRAXtYTdrXQ4C4us2V5
    * refact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
    [partitions.csv]
2026-10-12 feat(cad): support of EMAX ES-9051 servos (#70)
    [AiEmblem.3mf, AiEmblem.step, AiEmblem.stl, Bell.3mf, Bell.step, Bell.stl, Belly.3mf, Belly.step]
2026-10-12 fix(docs): include breakout photo in assembly guide
2026-10-12 feat(settings)!: store up to five wifi networks (#75)
    feat(settings)!: store up to five wifi networks
    Boot scans and joins the strongest saved network in range, then tries
    hidden/missed SSIDs in saved order. PUT /settings/wifi replaces the full
    list (1–5) in one NVS write; omit password to keep a saved one. GET
    /settings returns wifi_networks (SSIDs only). Legacy wifi_ssid/wifi_pass
    migrate into wifi_nets once.
    BREAKING CHANGE: GET /settings drops wifi_ssid and wifi_password_set;
    POST /settings no longer accepts wifi_ssid/wifi_password. Use
    PUT /settings/wifi and wifi_networks.
    ---------
    [getters.cpp, load.cpp, nvs.cpp, nvs.h, routes.cpp, settings.h, settings_handlers.cpp]
2026-10-13 refactor(http): rewrite the web UI in TypeScript and Preact, clean up the firmware HTTP layer (#77)
    * Centralize HTTP routing, access control, CORS, and error handling using WebServer middleware and a single route table.
    * Standardize JSON responses and request validation with ArduinoJson, replacing custom parsers.
    * Consolidate settings into structured values and patches, with validation, selective NVS writes, and reboot detection.
    * Rewrite the web UI in TypeScript and Preact with component-based architecture, routing, shared state, and reusable hooks.
    * Improve UI behavior, accessibility, async handling, and test coverage.
    * Strengthen TypeScript/ESLint rules and simplify firmware and UI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
    [access.cpp, access.h, anim_handlers.cpp, getters.cpp, handlers.h, health_handlers.cpp, load.cpp]
2026-10-16 fix(settings): improve handling of missing NVS keys and namespace initialization (#81)
    [load.cpp, nvs.cpp]
2026-10-16 docs(flash): clarify requirements for flashing ESP32-C3-Zero and update troubleshooting steps (#81)
2026-10-18 feat(firmware): guided-servo-calibration (#84)
    * docs(firmware): introduce spec od a new servos hub for assembly and guided calibration
    * feat(firmware): add guided servo calibration
    * refactor(servos): update default servo ranges to 80°–100° for all joints
    * refactor(setup): update servos hub terminology and improve guided calibration flow
    * refactor(calibration): enhance guided setup flow and UI feedback for servo calibration
    * refactor(calibration): implement gating for Identify controls until successful servo centering
    * refactor(calibration): add error handling for servo movements in guided calibration flow
    * chore(dependencies): downgrade jsdom to 29.1.1 and update related p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
    [servos.h]
2026-10-18 docs(firmware): update main specs with usb serial communication and guided servo calibration
2026-10-18 feat(servos): park before upload and restore last pose
2026-10-18 refactor(ui): enhance StatusBar component with dismiss button and improved styling
2026-10-18 docs(cad): add detailed instructions for printing the LampDiffuser with thin walls and update related documentation links
2026-10-19 feat(cli): add version command to print package version
2026-10-21 fix(cad): add a flexible belly joint to unload the torso servo shaft (#86) (#87)
    * fix(cad): add a flexible belly joint to unload the torso servo shaft (#86)
    * fix(firmware): update servo identification logic to accommodate body joint with increased delta range
    * fix(cad): tighten belly runner
    * fix(cad): reduce belly joint slack
    * docs(cad): update assembly instructions for Belly and Chair components, adding 'BellyJoint' and clarifying alignment steps
    * docs(cad): add description for BellyJoint component in 3D models README
    * fix(ci): improve KiCad installation process in CI workflow with retry logic and version checks
    * fix(ci): enhance KiCad installation in CI workflow by using App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
    [Belly.3mf, Belly.step, Belly.stl, BellyJoint.3mf, BellyJoint.step, BellyJoint.stl, BottomCover.3mf, BottomCover.step]
2026-10-22 refactor(firmware): remove servo_hold setting and related references
    This commit eliminates the `servo_hold` setting from the API and internal logic, ensuring that the servos will always release PWM after idle/sleep.
2026-10-22 feat(pcb): main control board rev3 (#66, #62)
    * add extension port
    * update BOM
    * update expected nets
    * update README.md for main control board: clarify extension port details and specify strapping pins and UART connections
    * update silkscreen layer for main control board: add knockout effect to VCC and voltage labels
    * add ESP antenna keepout
    * add 100nF to U4 dVdt
    * add capacitor next to pin 28 of PCA
    * update hardware documentation: clarify power distribution and GPIO pin usage on the main control board, including details on USB-C connections and extension headers
    * update silkscreen text on main control board: change label from "GP9" to "BOOT" and modify "GP8" to "GP8*"
    * docs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
    [main-control-board-esp32.kicad_sch, main-control-board-pca.kicad_sch, main-control-board.kicad_pcb, main-control-board.kicad_sch]
2026-10-23 feat(pcb): add HTML redirect page for Tiny Engineer PCB rev3
2026-10-23 feat(pcb): update main control board design with new silkscreen graphics and layout adjustments
    * Added new graphics to the silkscreen layer, including "SCAN TO ASSEMBLE" and "HUMAN, I NEED A BODY!" texts.
    * Updated the PCB design to include a QR code linking to the project website.
    * Rearranged designators in the kicad_pro file for better organization.
    [main-control-board.kicad_pcb]
2026-10-24 feat(web): enhance landing page content and structure
2026-10-27 feat(cad): add printable laptop screen inserts and generator (#88)
    * Generate correctly sized screen inserts for each servo preset using CAD measurements.
    * Add 13 customizable screen designs and per-preset A4 PDFs.
    * Support colour, greyscale, and background-free printing.
    * Add an interactive web editor with live preview, image upload, and PDF download.
    * Validate generated PDFs and preset data in CI.
    * Improve responsive layout, accessibility, and PDF validation.
